bulinrutss/injet-racing/implementacoes-futuras/README.md

# Implementações futuras — INJET RACING

Ideias **fora do escopo da Fase 1** (placa atual). Não implementar na prodv6 até o item ser puxado daqui.

| ID | Item | Prioridade | Status |
|----|---|---|---|
| FUT-01 | [3-step / rev-limit por corte de bobina](./FUT-01-3step-corte-bobina.md) | Alta (pista) | Ideia salva |
| FUT-02 | [Driver relé IRLZ44N / módulo opto (bobina >150 mA)](./FUT-02-rele-driver-irlz44n.md) | Baixa (só se relé pesado no chicote) | Ideia salva |
| FUT-03 | [Drag Star 650 · TBI comum + RPM (bobina vs pick-up)](./FUT-03-dragstar-650-tbi-rpm.md) | Média (piloto moto) | Ideia salva |
| FUT-04 | [Roda fônica · dentes · vs bobina](./FUT-04-roda-fonica-rpm.md) | Fase 2 | Referência |
| FUT-05 | [Condicionador VR · pick-up / distribuidor 2 fios](./FUT-05-condicionador-vr-pickup.md) | Fase 2 | Ideia salva |

**Regra:** cut de combustível **não** serve para 3-step / limiter sob carga — só faísca (bobina).
