bulinrutss/injet-racing/modulo/anotações.txt

espaço entre trilhas
colocar leds

me explique pq isso, pq funciona, então vamos dizer q se eu estendesse essa trilha 30cm e colocasse la os 2 cap, as dias pontas ainda são iguais?
