bulinrutss/injet-racing/assets/ecu-pcb-1layer-drc.md

# DRC

- Cruzamentos cobre: **0**
- Trilhas CNC: 86
- Fios topo (AWG28 pad–pad): **43**
- Placa: 240.0×160.0 mm
- GND: **pour** (sem fio de terra)

Sem tarja nas imagens.

## Fios topo

- `INJ2`
- `GI2`
- `INJ3`
- `INJ4`
- `RL1`
- `GR1`
- `RL2`
- `GR2`
- `RL3`
- `GR3`
- `IAT`
- `CLT`
- `MAP`
- `TPS`
- `RPMi`
- `RPMo`
- `CANH`
- `CANL`
- `IP`
- `VM`
- `VM`
- `UN`
- `RI`
- `VREF`
- `SWDIO`
- `SWCLK`
- `+12V`
- `+12V`
- `+12V`
- `+12V`
- `+12V`
- `+12V`
- `+5V`
- `+5V`
- `+5V`
- `+5V`
- `+3V3`
- `+3V3`
- `+3V3`
- `+3V3`
- `+3V3`
- `+3V3`
- `+3V3`
