bulinrutss/injet-racing/assets/ecu-pcb-prodv2-drc.md

# DRC — INJET RACING ECU prodv2 (1 camada)

- Placa: **240.0×160.0 mm** (maior que prod 200×100 — necessário para 0 curto)
- Cruzamentos cobre (nets diferentes): **0**
- Trilhas CNC (B.Cu): **86**
- Fios/jumpers TOPO: **43**
- Pads: **257**

## Estratégia

1. **GND = copper pour** — não roteado como trilha (evita ~30% dos conflitos)
2. **Canais horizontais** — 1 net por faixa Y para sinais
3. **`would_cross()`** — rejeita qualquer cruzamento; vira fio topo
4. **Potência por último** — barramentos +12V/+5V/+3V3 nas bordas

## Fios TOPO (soldar após CNC)

- `INJ2` (90.0,40.0) → (16.0,8.0)
- `GINJ2` (100.0,97.0) → (87.5,60.0)
- `INJ3` (108.0,40.0) → (20.0,8.0)
- `INJ4` (126.0,40.0) → (24.0,8.0)
- `RL1` (17.3,112.0) → (32.0,8.0)
- `GRL1` (100.0,86.8) → (16.0,96.0)
- `RL2` (31.3,112.0) → (28.0,8.0)
- `GRL2` (100.0,84.3) → (30.0,96.0)
- `RL3` (45.3,112.0) → (36.0,8.0)
- `GRL3` (100.0,81.7) → (44.0,96.0)
- `IAT` (40.0,14.0) → (176.0,128.0)
- `CLT` (44.0,14.0) → (176.0,116.0)
- `MAP` (48.0,14.0) → (176.0,104.0)
- `TPS` (52.0,14.0) → (184.0,92.0)
- `RPM_IN` (56.0,14.0) → (42.0,86.0)
- `RPM_OUT` (67.6,80.0) → (100.0,107.1)
- `CANH` (128.0,90.0) → (40.0,8.0)
- `CANL` (134.0,90.0) → (44.0,8.0)
- `IP` (200.0,60.0) → (152.0,112.2)
- `VM` (172.0,42.0) → (200.0,8.0)
- `VM` (202.0,46.5) → (200.0,8.0)
- `UN` (192.0,66.0) → (152.0,107.1)
- `RI_PULSE` (152.0,104.6) → (200.0,66.0)
- `VREF` (88.0,138.0) → (78.0,150.0)
- `SWDIO` (118.5,70.0) → (152.0,97.0)
- `SWCLK` (121.1,70.0) → (152.0,94.4)
- `+12V_PROT` (66.0,32.0) → (148.0,32.0)
- `+12V_PROT` (148.0,32.0) → (70.0,157.0)
- `+12V_PROT` (20.0,104.0) → (70.0,157.0)
- `+12V_PROT` (34.0,104.0) → (70.0,157.0)
- `+12V_PROT` (48.0,104.0) → (70.0,157.0)
- `+12V_PROT` (200.0,14.0) → (162.0,28.0)
- `+5V` (116.0,90.0) → (116.0,142.0)
- `+5V` (164.0,50.0) → (150.0,142.0)
- `+5V` (179.6,42.0) → (150.0,142.0)
- `+5V` (32.0,14.0) → (56.0,142.0)
- `+3V3` (168.0,128.0) → (168.0,136.0)
- `+3V3` (168.0,116.0) → (168.0,136.0)
- `+3V3` (168.0,104.0) → (168.0,136.0)
- `+3V3` (70.0,90.0) → (70.0,148.0)
- `+3V3` (116.0,70.0) → (116.0,148.0)
- `+3V3` (100.0,130.0) → (100.0,148.0)
- `+3V3` (36.0,14.0) → (72.0,148.0)

## vs injet-racing-prod

| | prod | prodv2 |
|---|---|---|
| Tamanho | 200×100 mm | 240×160 mm |
| Cruzamentos | ~896 | **0** |
| Jumpers topo | 0 | ~43 |
| GND | trilhas | **pour** |
