bulinrutss/injet-racing/assets/ecu-pcb-prodv3-drc.md

# DRC — INJET RACING ECU prodv3 (2 camadas FR4)

- Placa: **240.0×160.0 mm**
- **B.Cu:** 60 trilhas (roteamento principal prodv2)
- **F.Cu:** 25 trilhas (ex-jumpers prodv2 → cobre topo)
- **Fios/jumpers:** **0**
- **Vias F↔B:** **11**
- Cruzamentos B.Cu: **0**
- Cruzamentos F.Cu: **0**
- Sobreposição B.Cu: **0**
- Sobreposição F.Cu: **0**

## Stackup

| Camada | Função |
|---|---|
| F.Cu | Componentes THT + trilhas de ligação (face componentes) |
| FR4 | Core 1.6 mm |
| B.Cu | Trilhas principais + GND pour |

## vs prodv2

| | prodv2 | prodv3 |
|---|---|---|
| Camadas cobre | 1 (B.Cu) | **2 (F.Cu + B.Cu)** |
| Fios topo | 43 | **0** |
