bulinrutss/injet-racing/projetos piloto/README.md

# Projetos piloto — INJET RACING

Protótipos e produtos **fora** da placa ECU Fase 1 (prodv6). Cada subpasta = um piloto com documentação própria.

| Piloto | Status | Pasta |
|---|---|---|
| INJET 3 Step (limitador giros tipo ODG) | Documentado | [injet 3 step/](./injet%203%20step/) |

**Regra:** não implementar na prodv6 até puxar item de `implementacoes-futuras/` ou desta pasta para escopo ativo.
