bulinrutss/injet-racing/TBI's.xlsx - MOTO x TBI.pdf

## Lista de TBI's Compatíveis

A lista é seguir é uma referência / sugestão de TBI's (Corpo de Injeção) que são compatíveis com determinados modelos de moto. A instalação da TBI na moto é uma adaptação e está sucetível à ajustes para um perfeito encaixe no motor.

MOTO | TBI
Honda CG 125/150 | Honda CG 150
Honda CBX 250 Twister | Honda CB 250 Twister ou CB 300
Honda XR 250 Tornado | Honda CB 250 Twister ou CB 300
Honda NX-4 Falcon 400 | Honda NX-4 Falcon 400 ou CB 300
Honda CRF 230 | Honda CB 250 Twister ou CB 300
Honda NX 350 Sahara | Honda CB 300
Honda CB 400/450 | Honda CB 500X
Honda CBX 750 | Honda Hornet 600
Honda CBR 450 SR | 2 TBI de Fazer 250
Honda CB 500 | Honda CB 500X
Honda CBR 600 | Honda Hornet 600
Honda Shadow 600 (1 Carburador) | Honda Shadow 750 (Coletor de Admissão e Corpo de Injeção)
Honda Shadow 600 (2 Carburadores) | Yamaha Fazer 250 (2 TBI's) - Cabo de Acelerador Mirage 250
Honda Shadow 750 | Honda Shadow 750 (Coletor de Admissão e Corpo de Injeção)
Yamaha Crypton 115 | Honda Pop 110 ou Honda BIZ 125
Yamaha YBR 125 | Yamaha Fazer 150
Yamaha DT 200 | Yamaha Fazer 250 ou Honda Twister 250
Yamaha Virago 535 | Yamaha Fazer 250 (2 TBI's) - Cabo de Acelerador Mirage 250
Yamaha Virago 750 | Honda CB 300 (2 TBI's)

Yamaha Drag Star 650 | Yamaha Fazer 250 (2 TBI's) - Cabo de Acelerador Mirage 250
Yamaha XT 600 / Ténéré 600 | Yamaha MT 03
Yamaha Super Ténéré 750 | BMW F800
Yamaha TDM 850 | BMW F800
Yamaha VMax 1200 | Sugerimos não usar TBI.
Suzuki Intruder 250 | Yamaha Fazer 250
Suzuki GS 500 | Yamaha Fazer 250 (2 TBI's) - Cabo de Acelerador Mirage 250
Suzuki GSX 750 | Suzuki Bandit 650 ou 1.250
Suzuki GSXR 1100w | Suzuki Bandit 650 ou 1.250
Suzuki DR 650 | BMW F650 GS
Suzuki DR 800 | BMW F800
Suzuki LS 650 Savage | BMW F650 GS
Suzuki VZ 800 Marauder | Honda CB 300 (2 TBI's)
Suzuki VS 800 Intruder | Honda CB 300 (2 TBI's)
Suzuki VS 1400 Intruder | Honda CB 300 (2 TBI's)
Kawasaki Ninja Zx11 | Suzuki Bandit 1.250, Z 800
Kawasaki Vulcan 750 | Kasinski Mirage 650 (2 TBI's)
Dafra Horizon 150 | Honda CG 150
Kawasaki Ninja Zx9R | KAWASAKI Z800
Suzuki Bandit 600 | Bandit 650
Sundown 125 | Burgman 125

Observações

Na adaptação pelo carburador, não usa TPS/Reading Box
