bulinrutss/injet-racing/assets/bico-0280156086.png

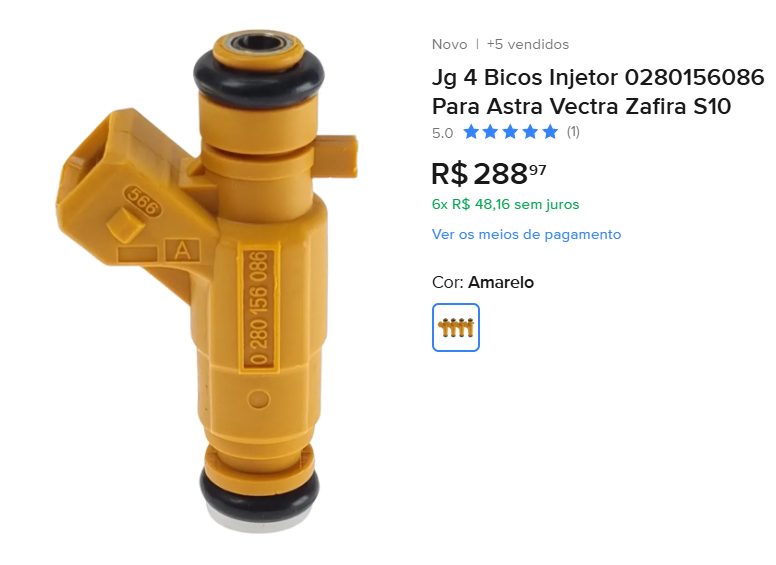
assets/bico-0280156086.png
