bulinrutss/injet-racing/assets/corpo-completo-tbi-3d-v6.png

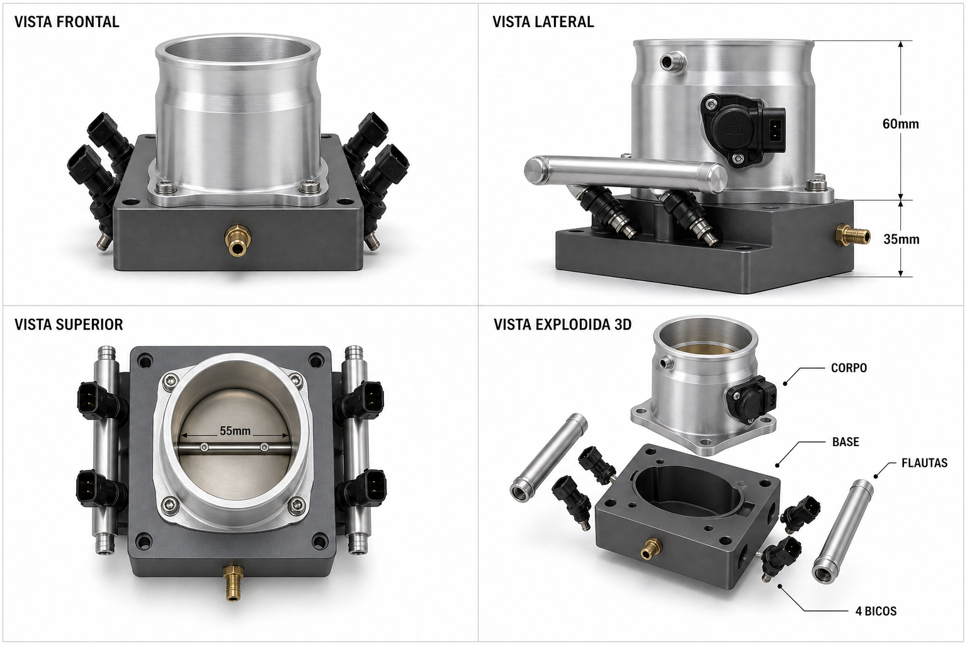
assets/corpo-completo-tbi-3d-v6.png
