bulinrutss/injet-racing/assets/ecu-fenolite-100x200-layout.png

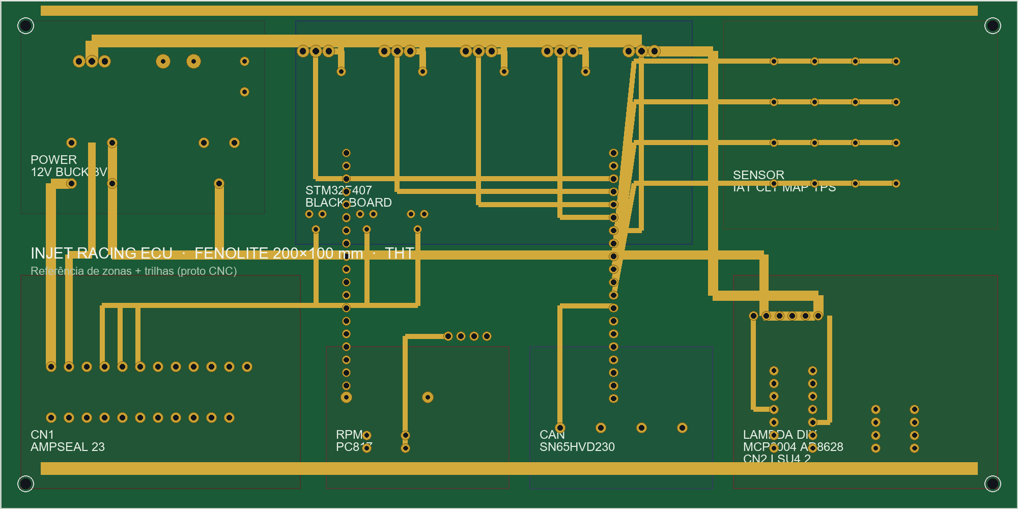
assets/ecu-fenolite-100x200-layout.png
