bulinrutss/injet-racing/assets/ecu-fenolite-100x200-traces-cnc-invert.png

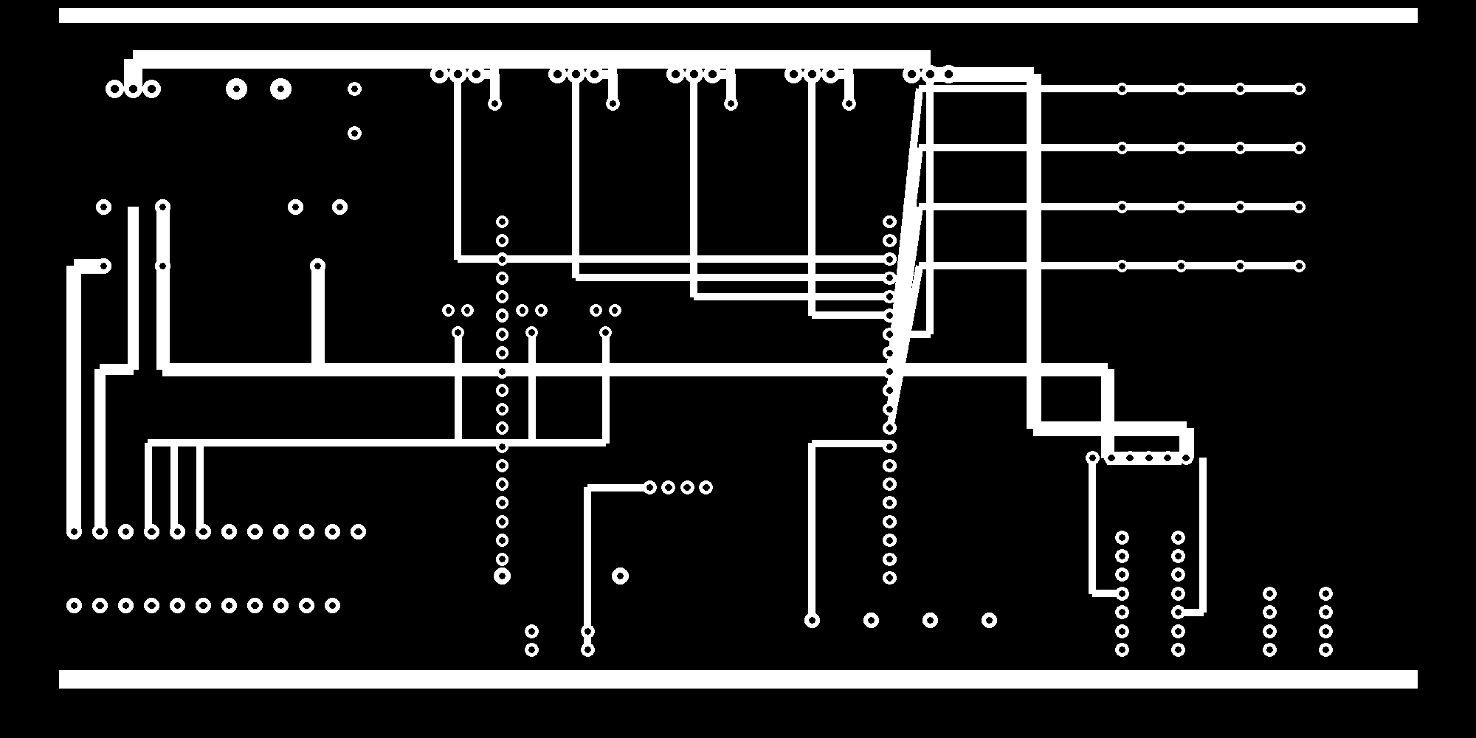
assets/ecu-fenolite-100x200-traces-cnc-invert.png
