bulinrutss/injet-racing/assets/ecu-fenolite-100x200-traces-cnc.png

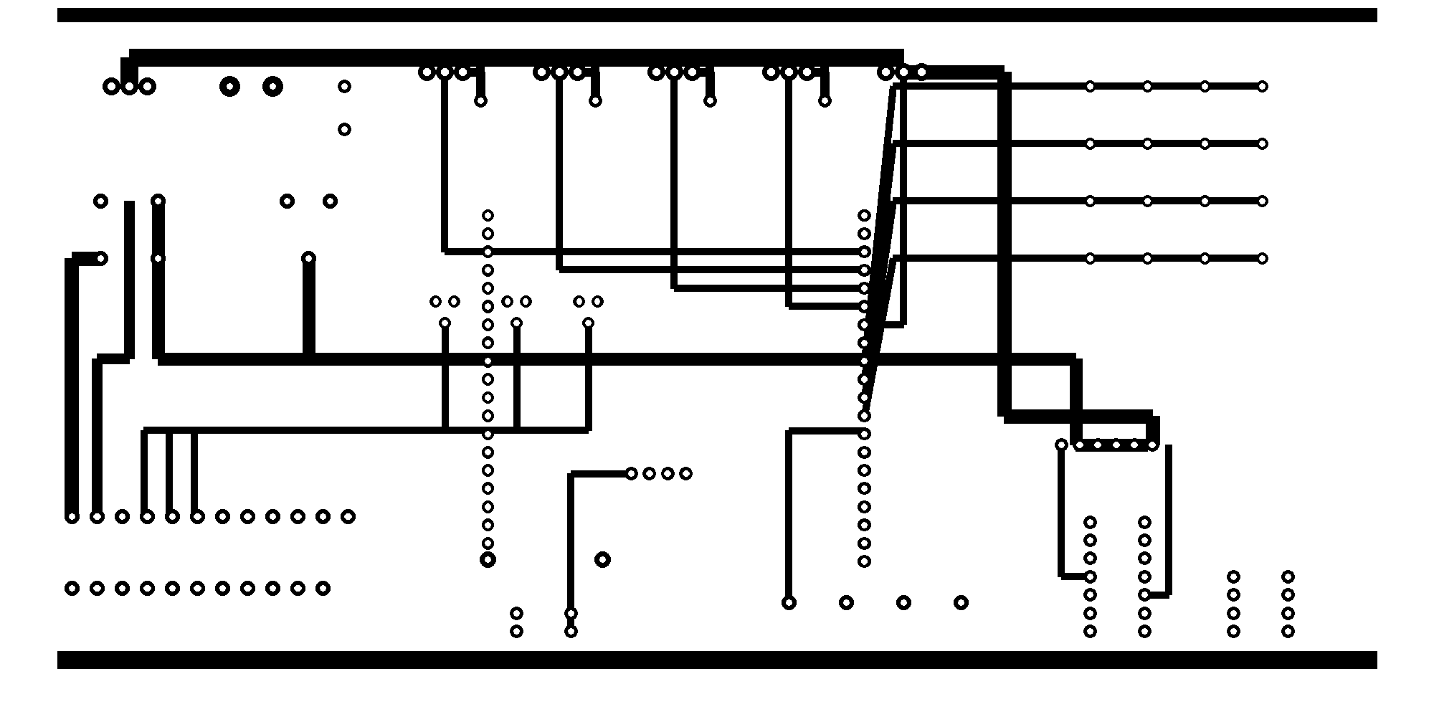
assets/ecu-fenolite-100x200-traces-cnc.png
