bulinrutss/injet-racing/assets/ecu-pcb-1layer-pads-map.png

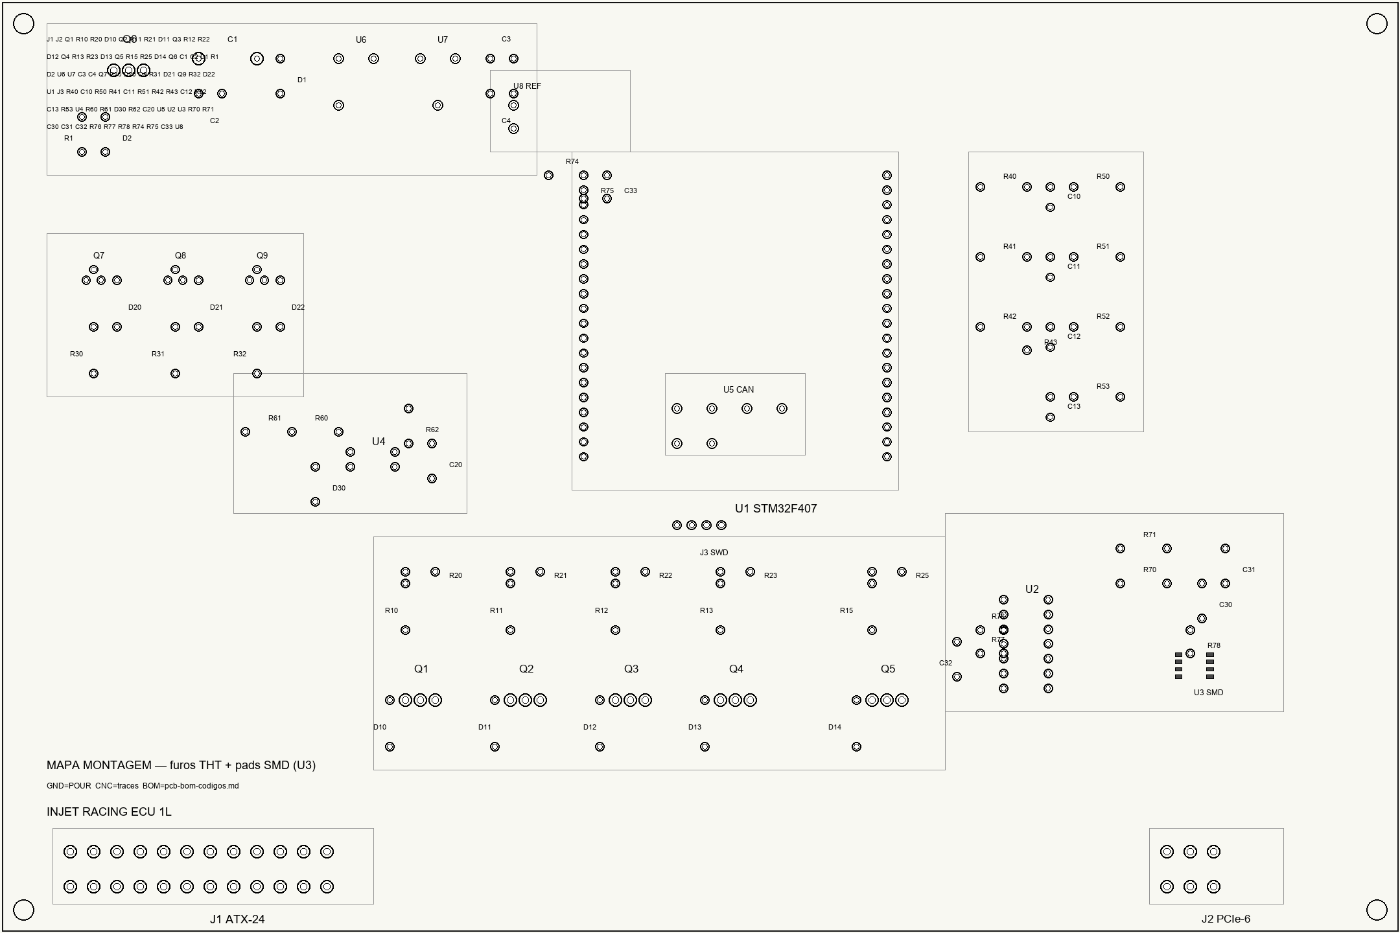
assets/ecu-pcb-1layer-pads-map.png
