bulinrutss/injet-racing/assets/ecu-pcb-1layer-traces-cnc-invert.png

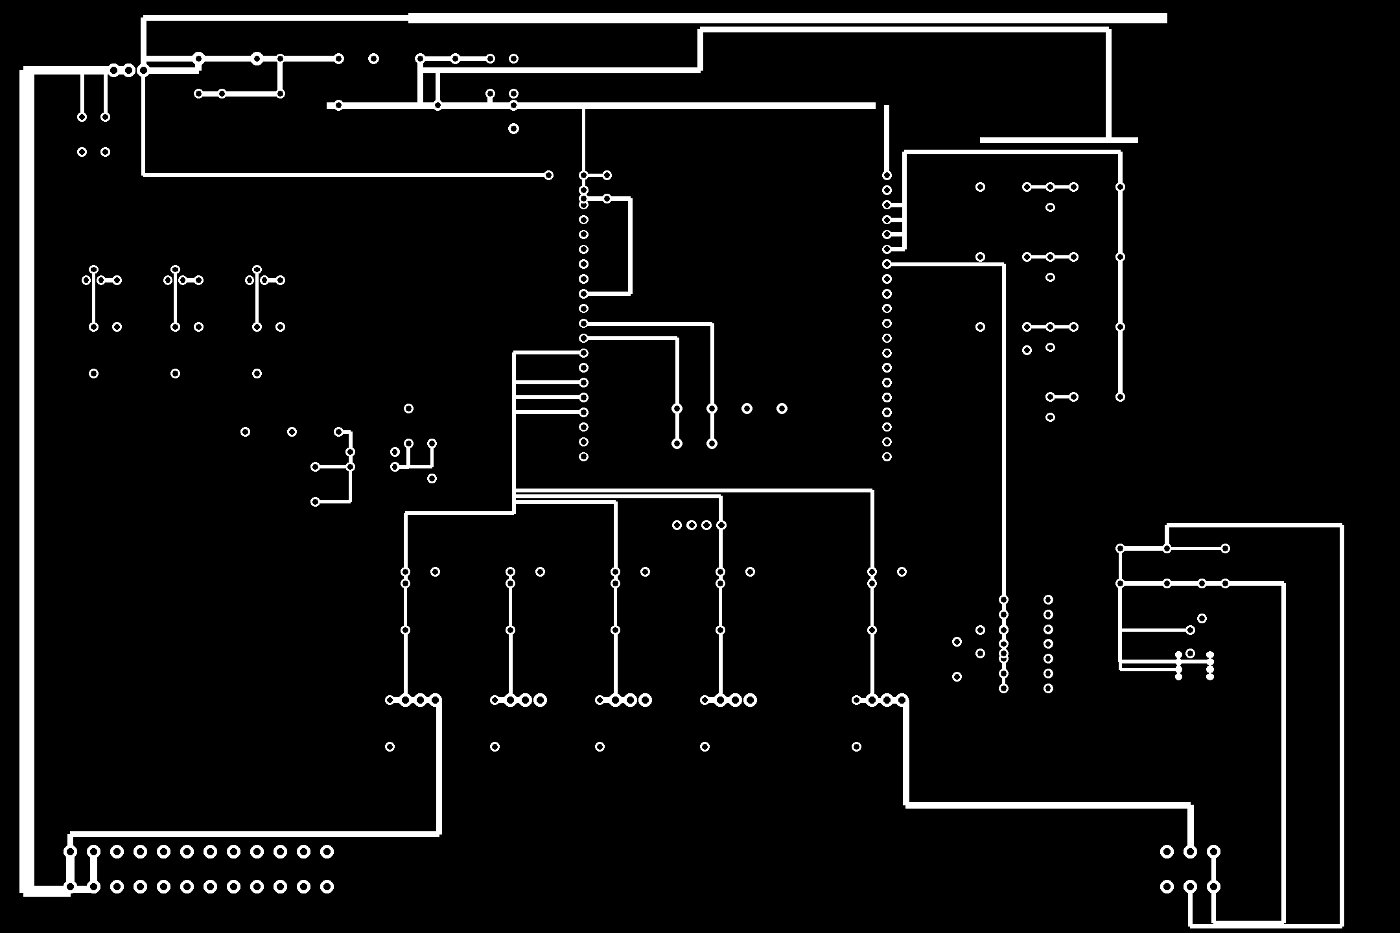
assets/ecu-pcb-1layer-traces-cnc-invert.png
