bulinrutss/injet-racing/assets/flange-55mm-3d-v5.png

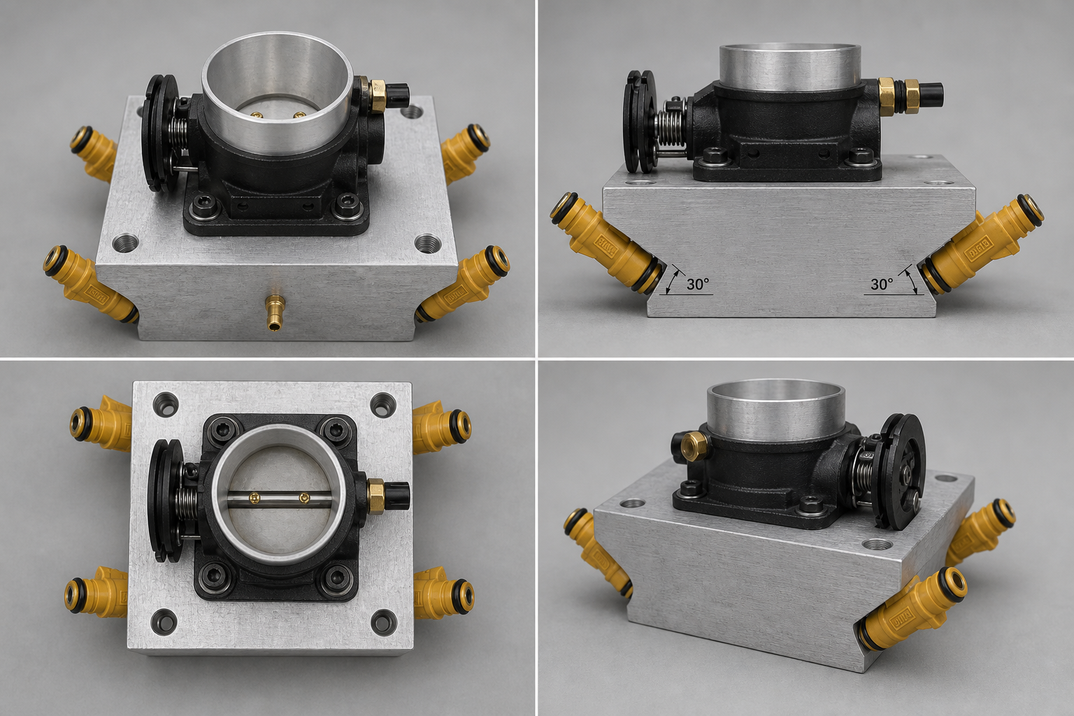
assets/flange-55mm-3d-v5.png
