bulinrutss/injet-racing/assets/flange-55mm-cotas-v5.png

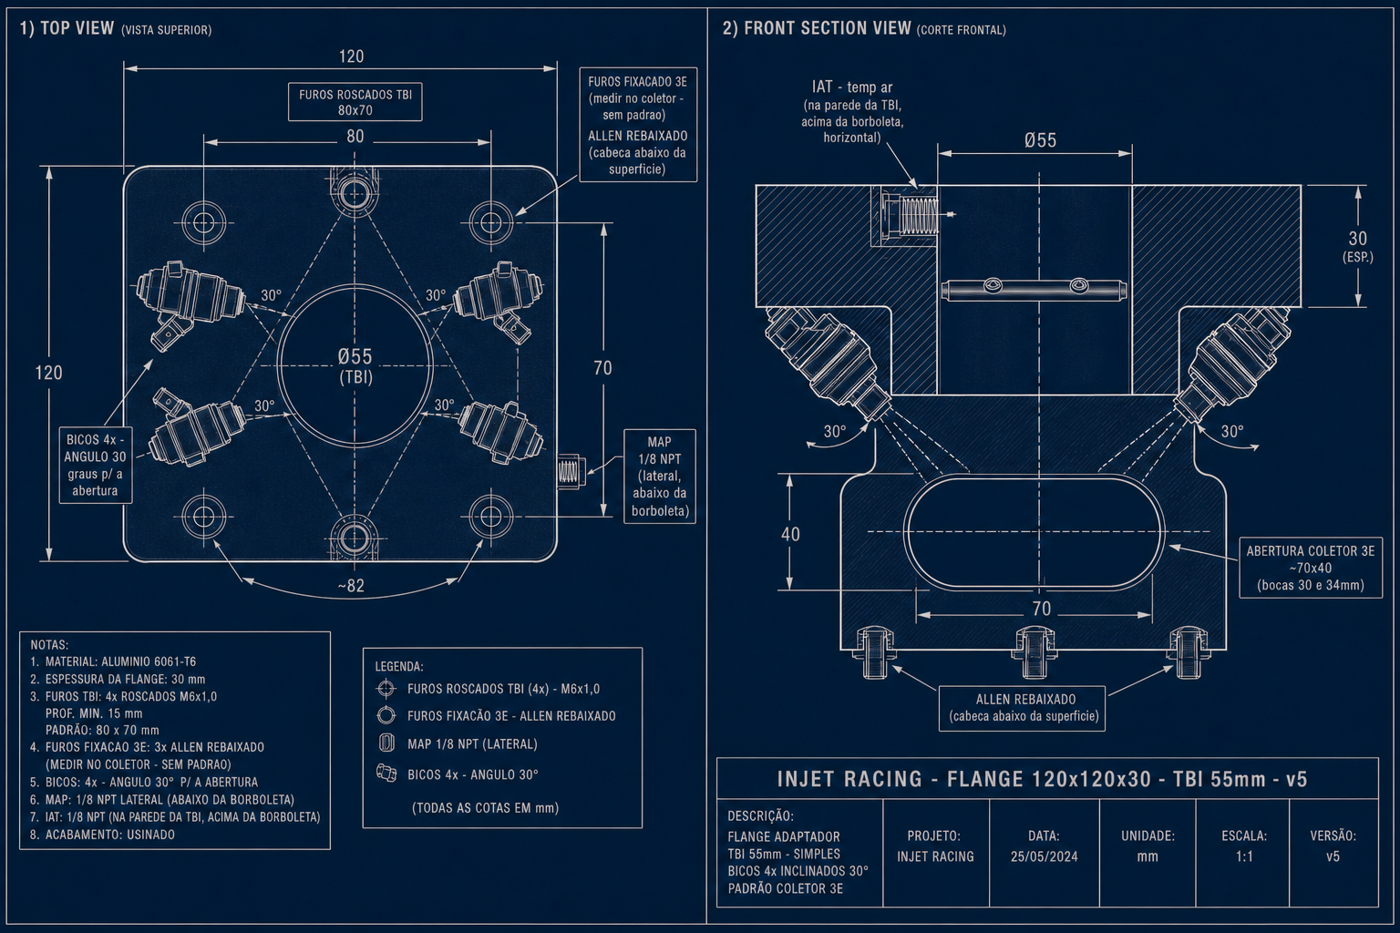
assets/flange-55mm-cotas-v5.png
