bulinrutss/injet-racing/assets/flange-55mm-passos-v5.png

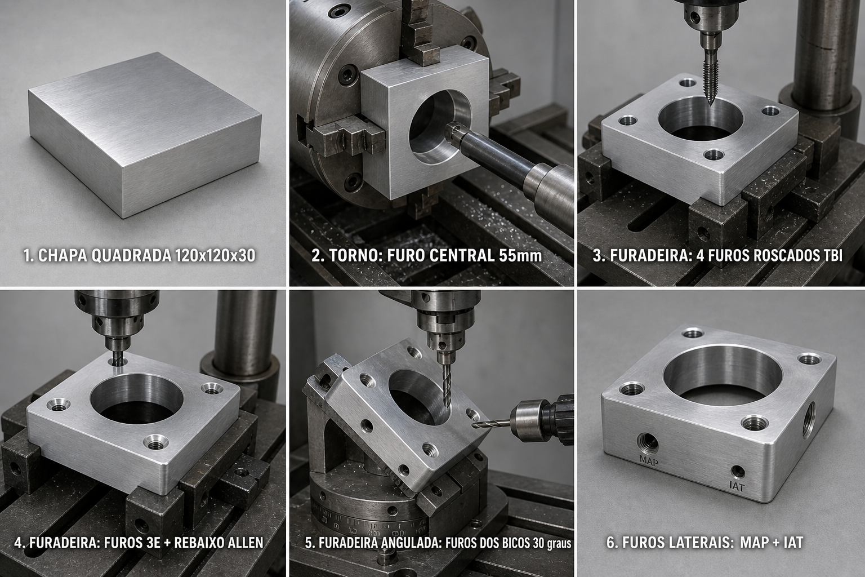
assets/flange-55mm-passos-v5.png
