bulinrutss/injet-racing/assets/flange-tbi-3d-4angulos.png

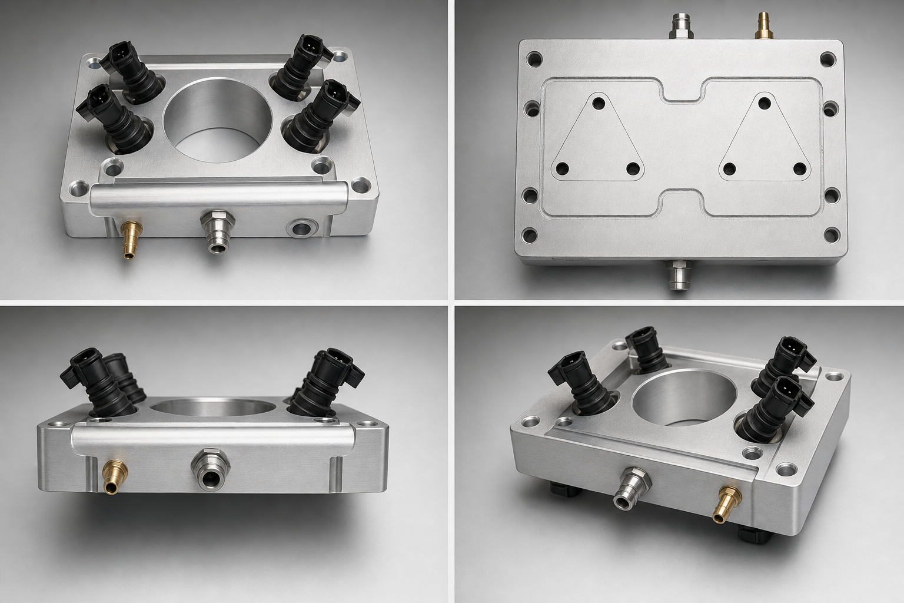
assets/flange-tbi-3d-4angulos.png
