bulinrutss/injet-racing/assets/flange-tbi-3d-v2.png

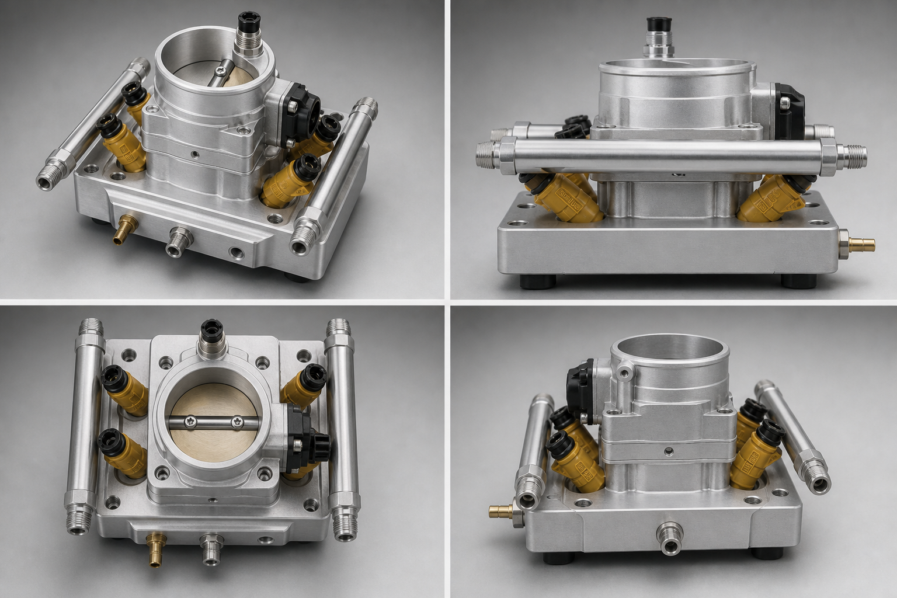
assets/flange-tbi-3d-v2.png
