bulinrutss/injet-racing/assets/flange-tbi-3d-v3.png

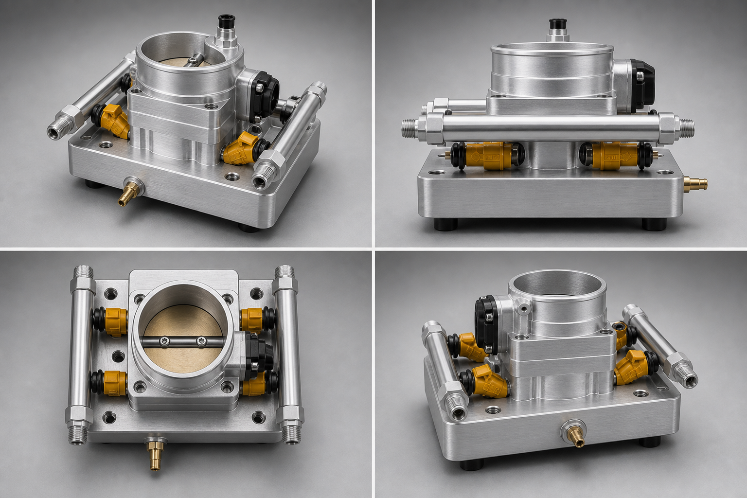
assets/flange-tbi-3d-v3.png
