bulinrutss/injet-racing/assets/flange-tbi-cotas-v2.png

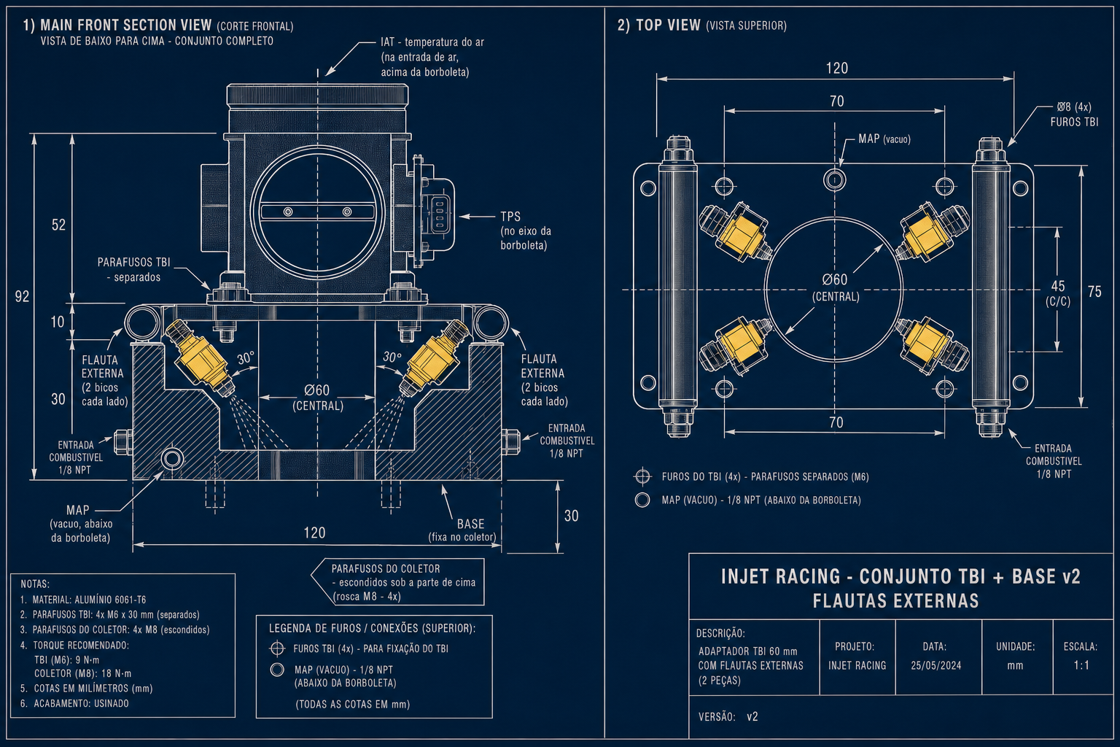
assets/flange-tbi-cotas-v2.png
