bulinrutss/injet-racing/assets/flange-tbi-cotas-v3.png

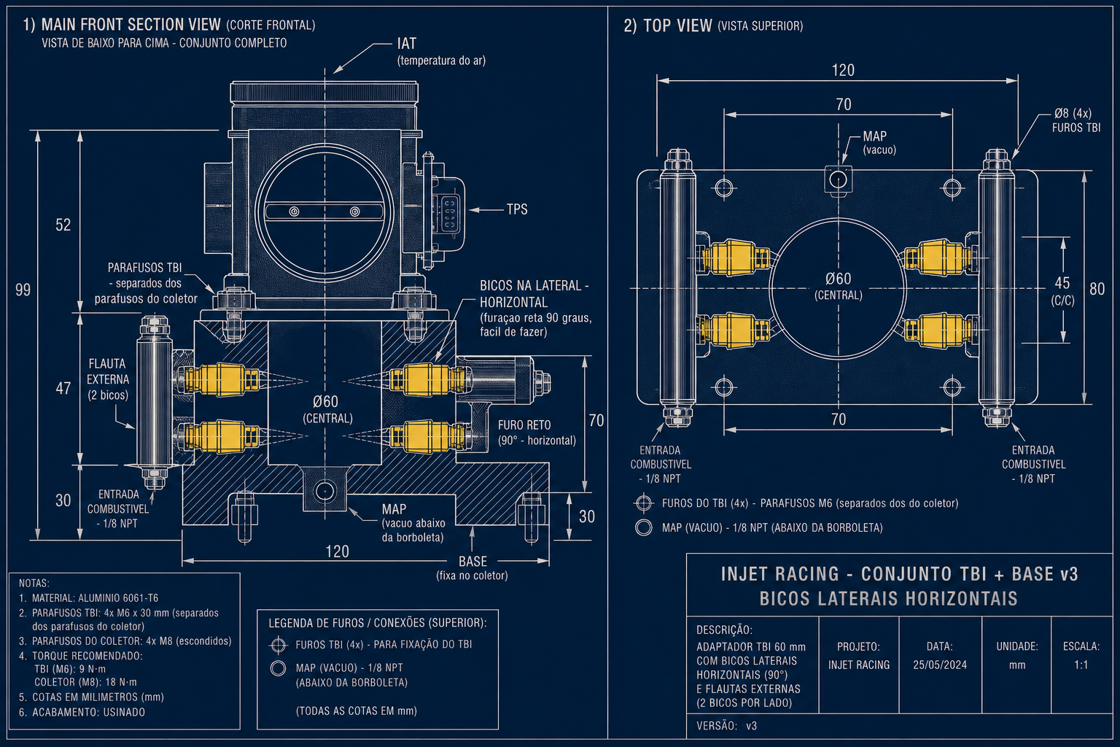
assets/flange-tbi-cotas-v3.png
