bulinrutss/injet-racing/assets/flange-tbi-cotas.png

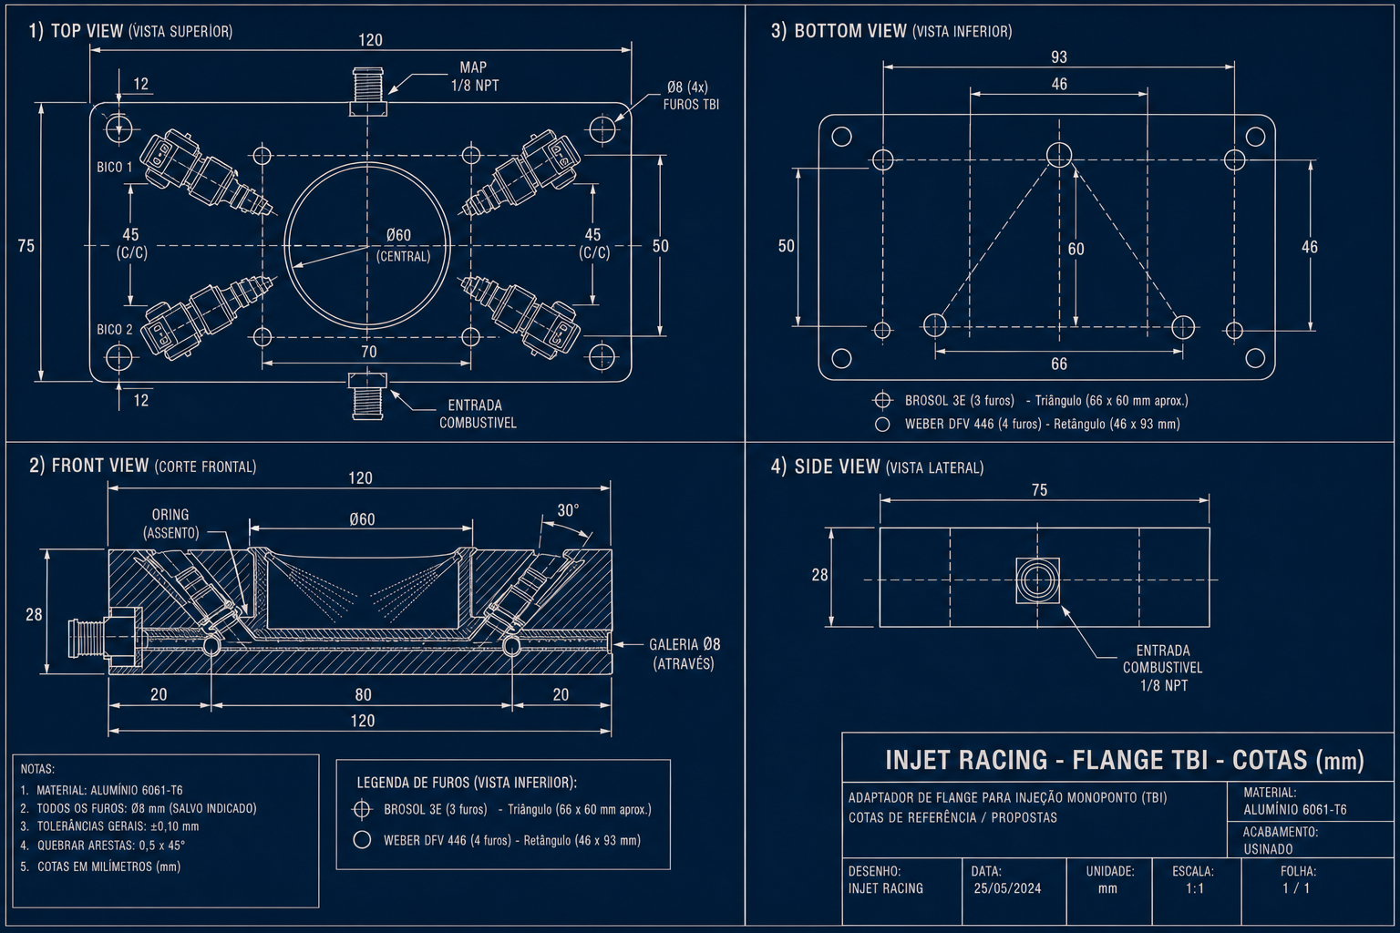
assets/flange-tbi-cotas.png
