bulinrutss/injet-racing/assets/flange-tbi-explodida-v2.png

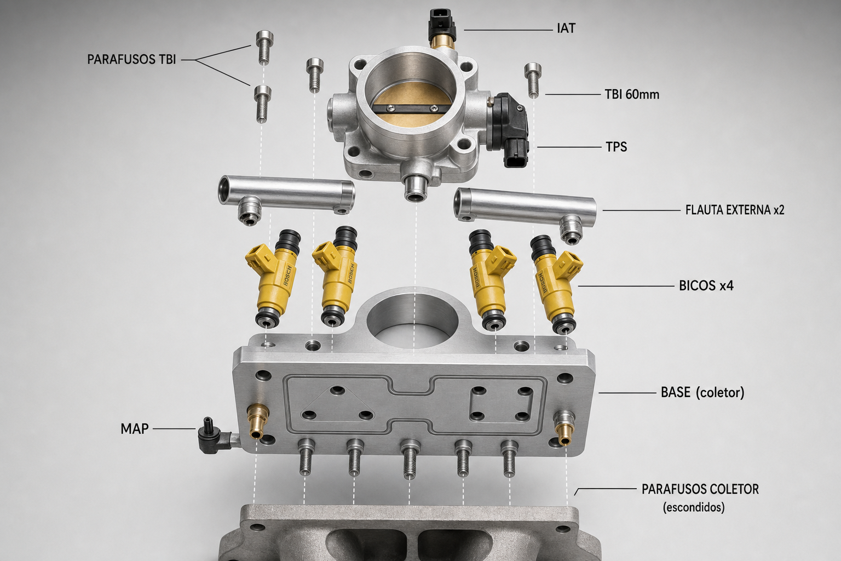
assets/flange-tbi-explodida-v2.png
