bulinrutss/injet-racing/assets/flange-tbi-explodida-v3.png

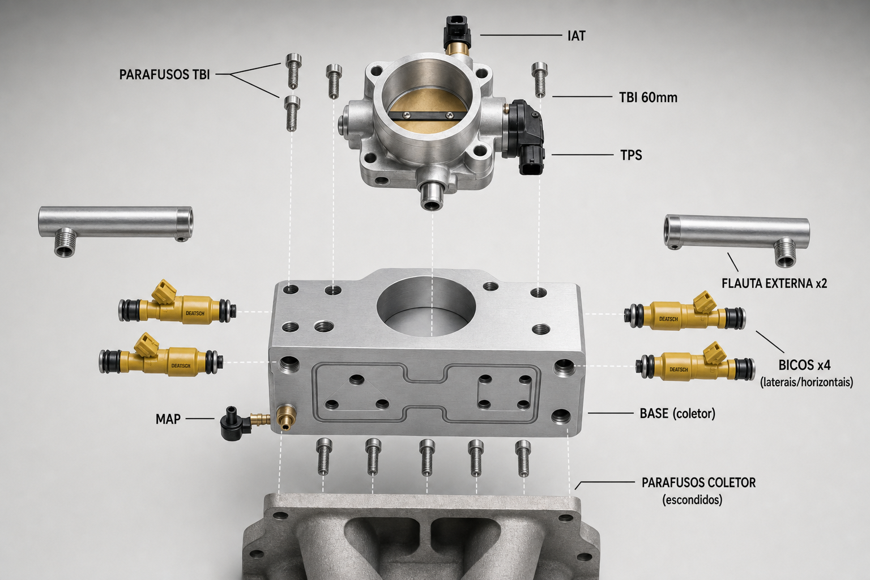
assets/flange-tbi-explodida-v3.png
