bulinrutss/injet-racing/assets/flange-tbi-projeto.png

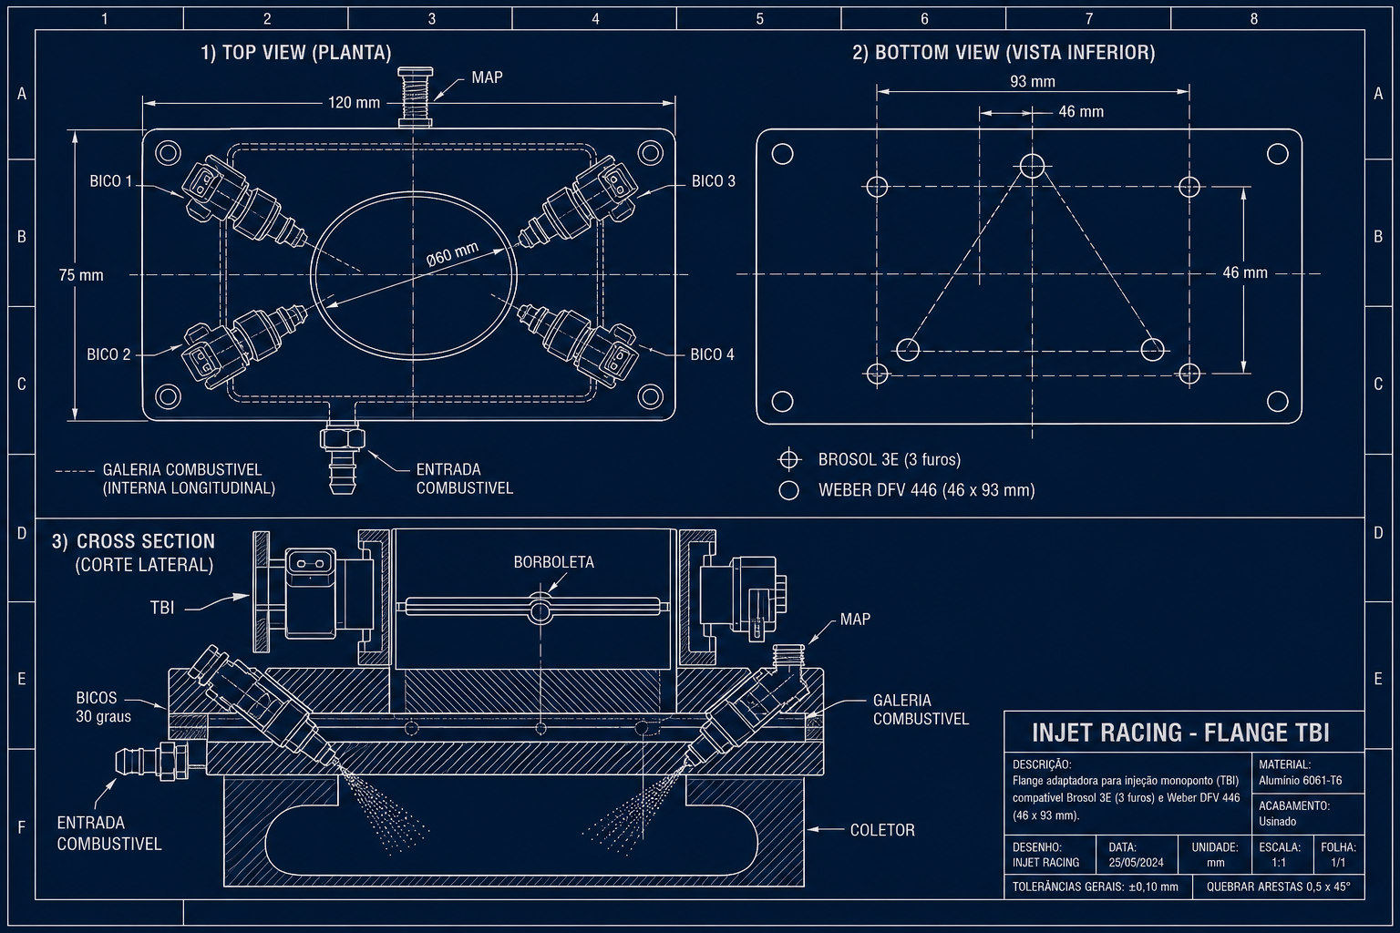
assets/flange-tbi-projeto.png
