bulinrutss/injet-racing/assets/flange-torno-3d-v4.png

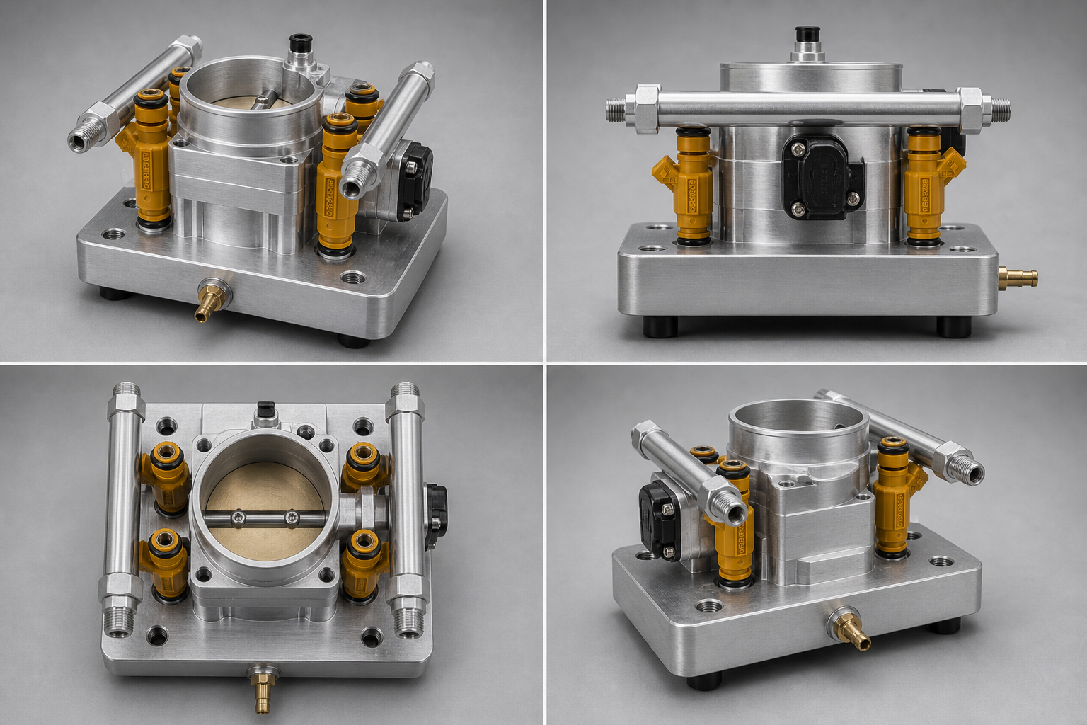
assets/flange-torno-3d-v4.png
