bulinrutss/injet-racing/assets/flange-torno-passos-v4.png

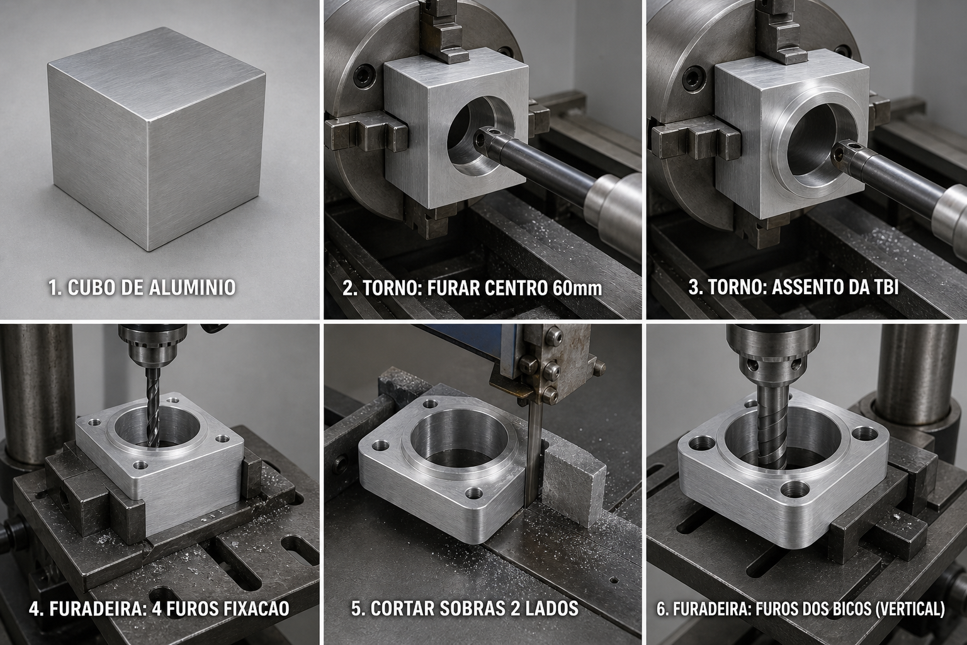
assets/flange-torno-passos-v4.png
