bulinrutss/injet-racing/assets/tbi-55mm-furacao.png

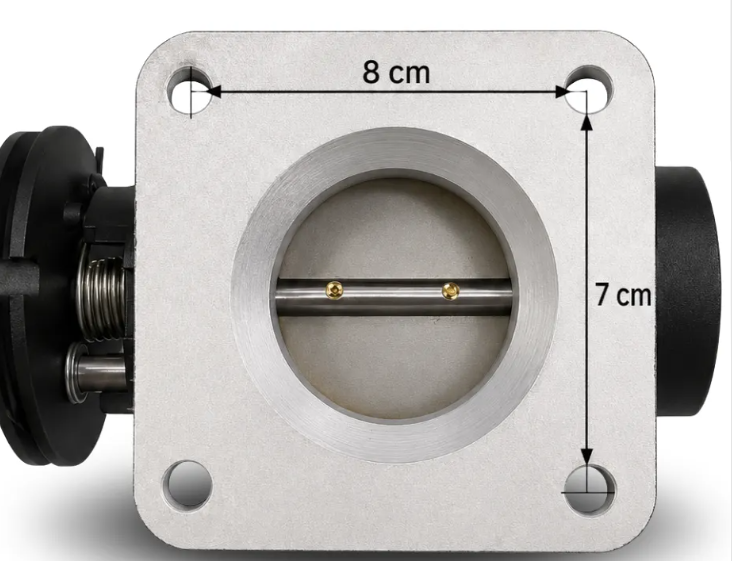
assets/tbi-55mm-furacao.png
