bulinrutss/injet-racing/assets/tbi-55mm-vista.png

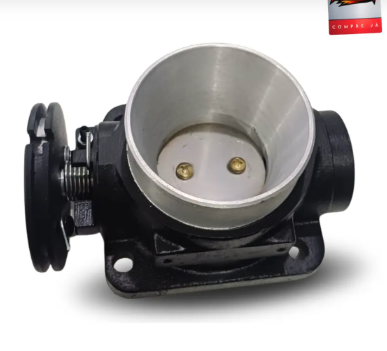
assets/tbi-55mm-vista.png
