bulinrutss/injet-racing/projetos piloto/injet 3 step/README.md

# INJET 3 Step — projeto piloto

Limitador de giros tipo ODG 3-step (burn-out / pre-stage / corte final + shift light), corte na **bobina**, produto **standalone** fora da prodv6 Fase 1.

| Arquivo | Conteúdo |
|---|---|
| [01-projeto-detalhado.md](./01-projeto-detalhado.md) | Objetivo, tecnologia ODG, instalação A/B/C, BOM, riscos, próximos passos |
| [02-custos.md](./02-custos.md) | Preços Ali / BR / ML, solda, fabricação, totais |
| [03-tempo-fabricacao.md](./03-tempo-fabricacao.md) | Horas CNC, solda, 3D, chicote, firmware, cronograma |

**Relacionado:** `implementacoes-futuras/FUT-01-3step-corte-bobina.md`
