bulinrutss/injet-racing/assets/ecu-pcb-prodv2-assembly.png

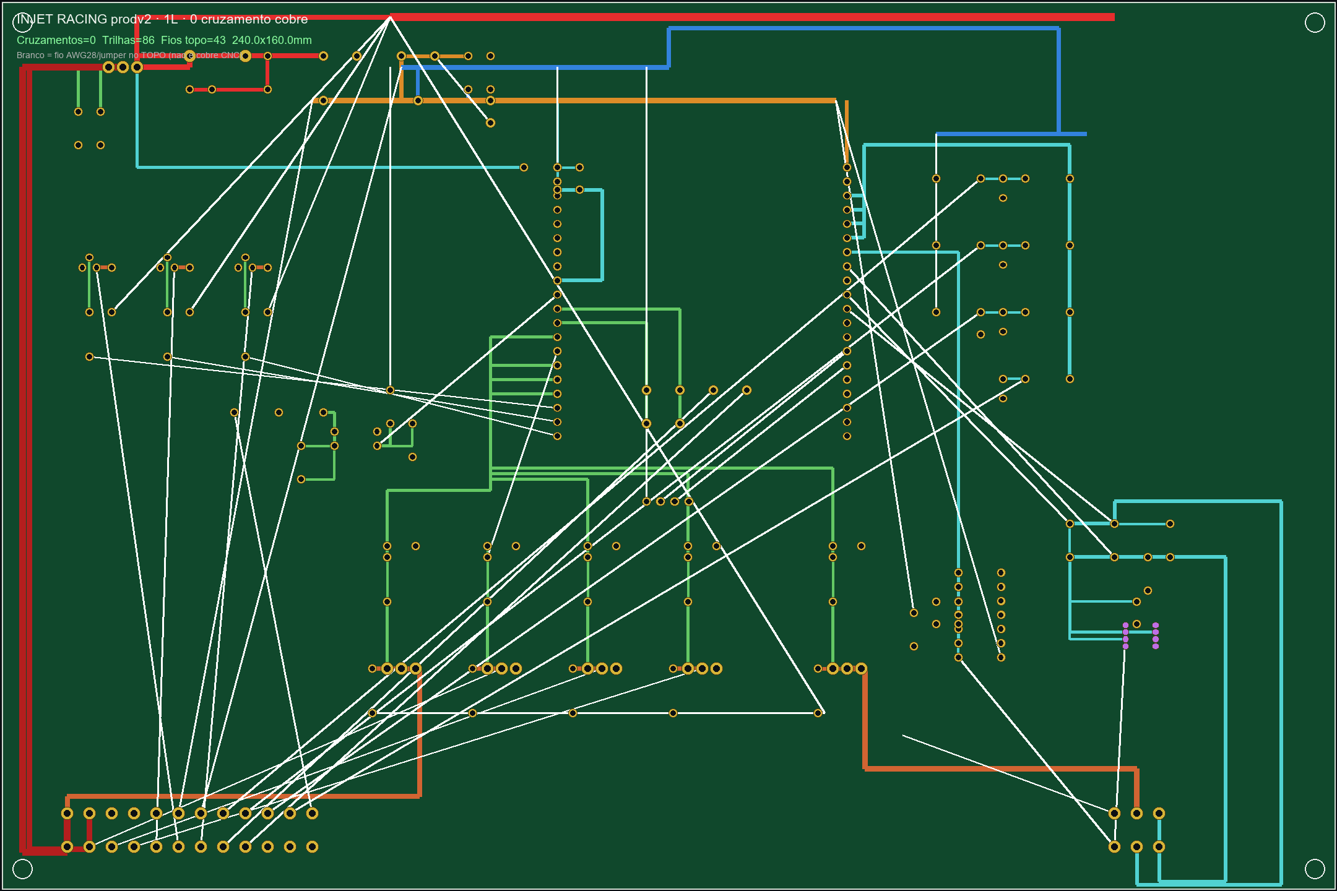
assets/ecu-pcb-prodv2-assembly.png
