bulinrutss/injet-racing/assets/ecu-pcb-prodv3-assembly.png

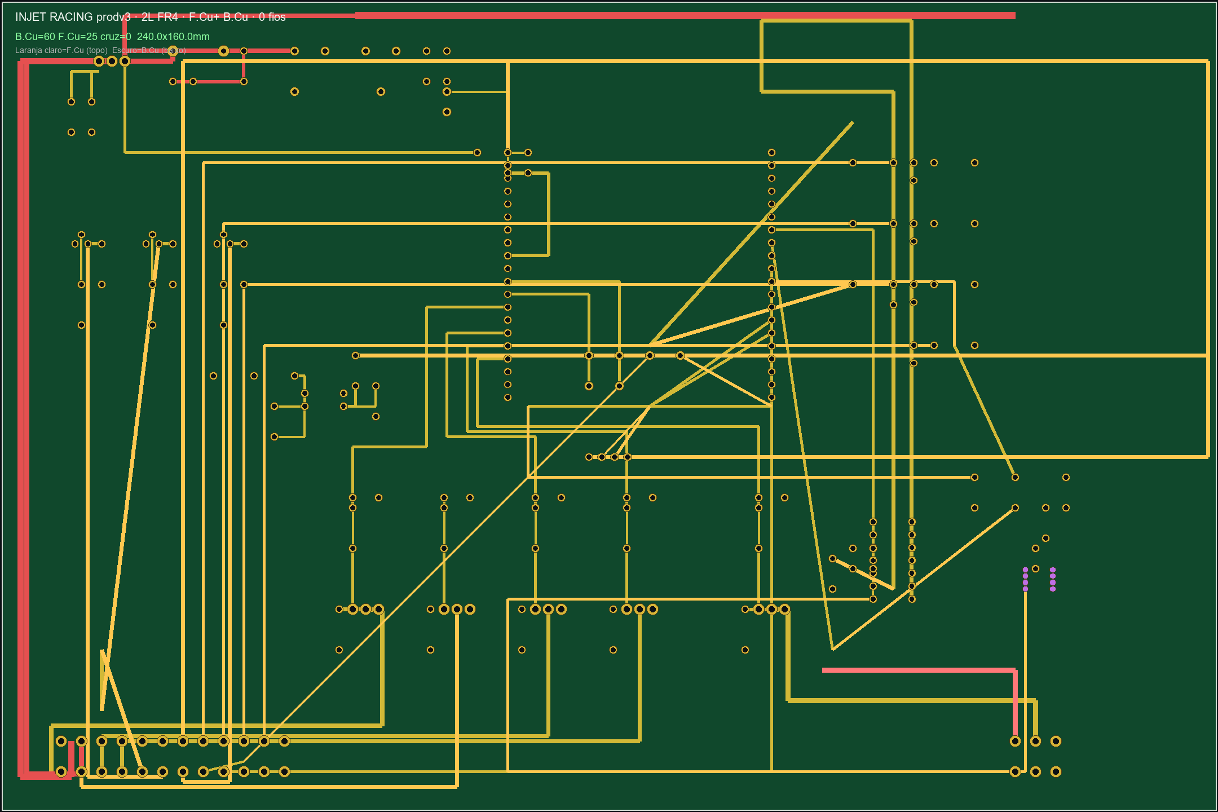
assets/ecu-pcb-prodv3-assembly.png
