bulinrutss/injet-racing/kicad/prodv6/injet-racing-prodv6.kicad_pcb

## KiCad design kicad/prodv6/injet-racing-prodv6.kicad_pcb (2026-11-11)

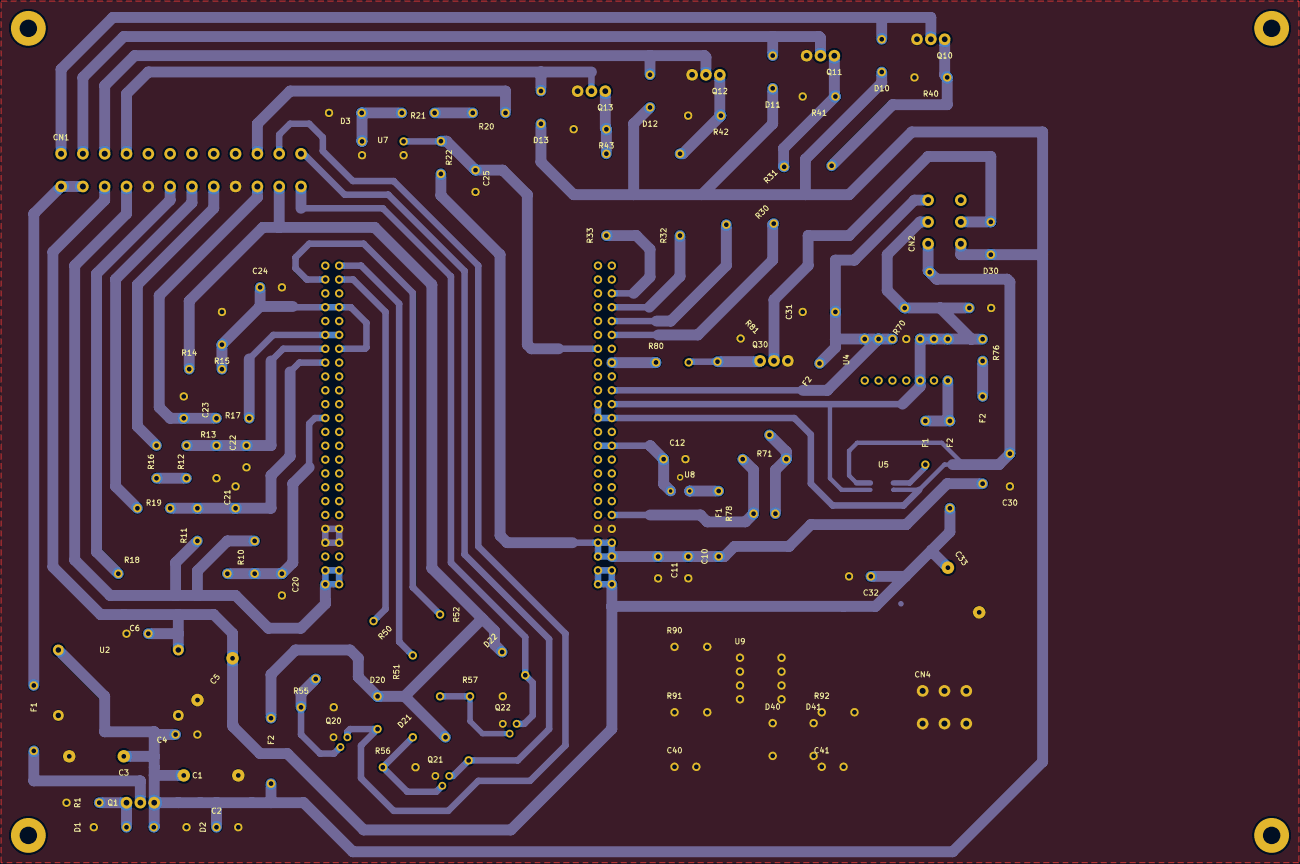
[picture p33: board injet-racing-prodv6.kicad_pcb from above]

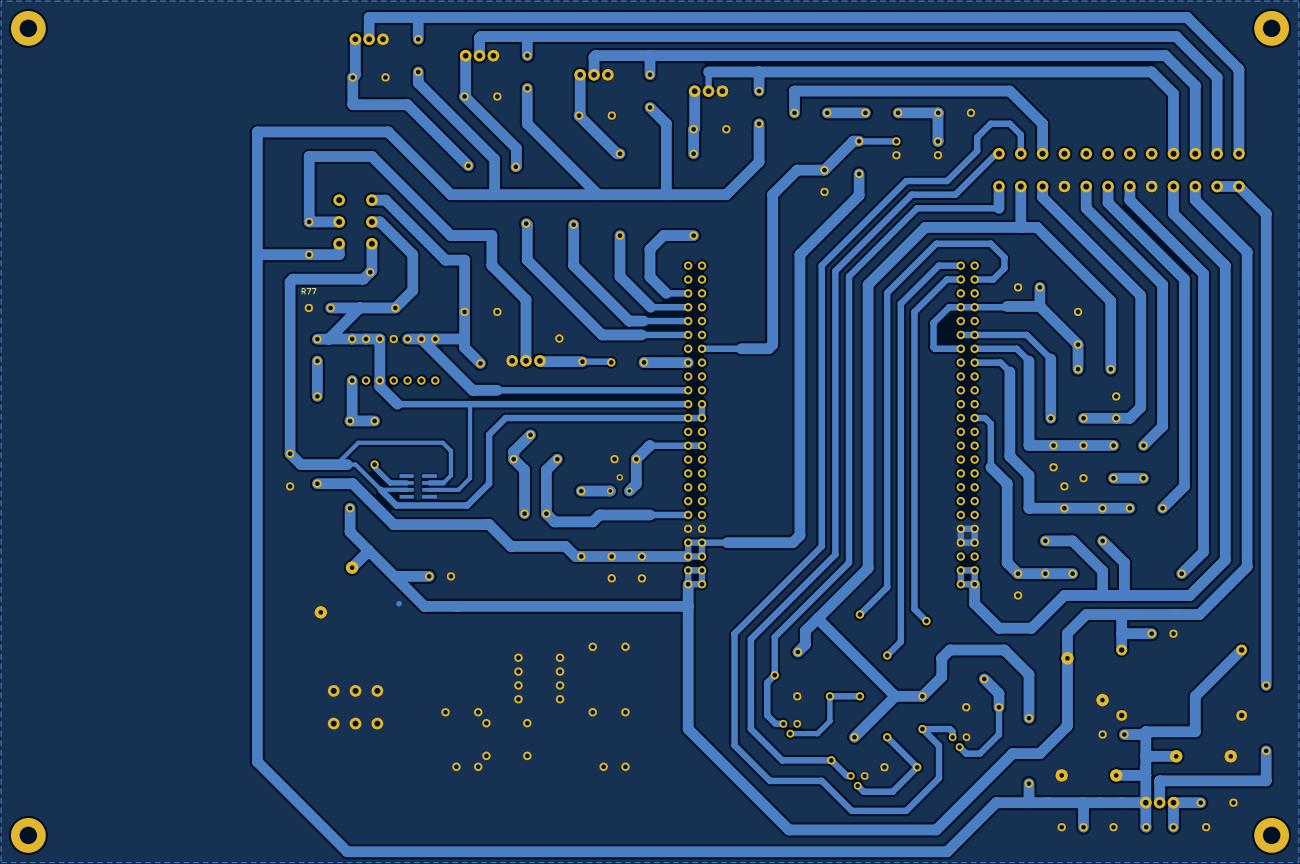
[picture p34: board injet-racing-prodv6.kicad_pcb from below]

Board: 2 copper layers, 102 parts (3 on the bottom side), 37 nets.

Parts:
C1: 220uF; C1
C2: 100nF; C2
C3: 100uF; C3
C4: 100nF; C4
C5: 220uF; C5
C6: 100nF; C6
C10: 100nF; C10
C11: 10uF; C11
C12: 10uF; C12
C20: 100nF; C20
C21: 100nF; C21
C22: 100nF; C22
C23: 100nF; C23
C24: 100nF; C24
C25: 1nF; C25
C30: 220nF; C30
C31: 220nF; C31
C32: 100nF; C32
C33: 10uF; C33
C40: 10nF; C40
C41: 1nF; C41
CN1: ATX-24; CN1
CN2: PCIe-6; CN2
CN4: PCIe-6 VR; CN2
D1: 15V Zener; D1
D2: TVS 33V; D2
D3: 1N4148; D3
D10: 1N4007; D10
D11: 1N4007; D11
D12: 1N4007; D12
D13: 1N4007; D13
D20: 1N4007; D20
D21: 1N4007; D21
D22: 1N4007; D22
D30: 1N4007; D30
D40: 1N4148; D40
D41: 1N4148; D41
F1, F1#2, F1#3, F2, F2#2, F2#3, F2#4: 5A; F1
H: MountingHole; MountingHole_3.2mm_M3
H#2, H#3, H#4: MountingHole; MountingHole_3.2mm_M3
Q1: IRF9540; QREV
Q10: IRLZ44N; Q10
Q11: IRLZ44N; Q11
Q12: IRLZ44N; Q12
Q13: IRLZ44N; Q13
Q20: 2N7000; Q20
Q21: 2N7000; Q21
Q22: 2N7000; Q22
Q30: IRLZ44N; Q30
R1: 100k; R1
R10, R11: 2.26k; R
R12, R40, R41, R42, R43, R55, R56, R57, R76, R77: 10k; R
R13: 18k; R13
R14, R91: 100k; R
R15: 10k; R15
R16, R17, R18, R19, R50, R51, R52: 1k; R
R20, R21: 10k 2W; R
R22, R92: 4k7; R
R30, R31, R32, R33, R80: 100R; R
R70: 61R9; R
R71: 6k8; R
R78: 1k; R78
R81: 10k; R81
R90: 47k; R
U1: STM32F4VE; BLACK_BOARD
U2: MP1584
U4: MCP6004; U6004
U5: OPA388IDR; U8628
U7: PC817
U8: REF3033; U8
U9: LM393

Connections:
+3V3: C10.A, C11.A, CN1.4, D40.K, F1#3.A, F1#3.B, F2#3.A, F2#3.B, R10.A, R11.A, R22.B, R76.A, R92.A, U1.L0I, U1.L0O, U1.L1I, U1.L1O, U1.R2I, U1.R2O, U1.R3I, U1.R3O, U8.1, U9.8
+5V: C5.A, C6.A, C32.A, C33.A, CN1.3, F1.A, F1.B, F2#4.A, F2#4.B, U1.R0I, U1.R0O, U1.R1I, U1.R1O, U2.3, U4.14, U5.7
+12V_BAT: CN1.1, CN1.2, F1#2.A
+12V_IN: F1#2.B, Q1.D
+12V_PROT: C1.A, C2.A, C3.A, C4.A, CN1.11, CN2.1, D2.A, D10.K, D11.K, D12.K, D13.K, D20.K, D21.K, D22.K, D30.K, F2.A, F2.B, Q1.S, R14.A, U2.1
CLT: C21.A, CN1.7, R11.B, R19.A, R19.B, U1.L16O
GHEAT: Q30.G, R80.A, R80.B, R81.A, U1.R16I
GINJ1: Q10.G, R30.A, R30.B, R40.A, U1.R18I
GINJ2: Q11.G, R31.A, R31.B, R41.A, U1.R19I
GINJ3: Q12.G, R32.A, R32.B, R42.A, U1.R20I
GINJ4: Q13.G, R33.A, R33.B, R43.A, U1.R21I
GND: C1.B, C2.B, C3.B, C4.B, C5.B, C6.B, C10.B, C11.B, C12.B, C20.B, C21.B, C22.B, C23.B, C24.B, C25.B, C30.B, C31.B, C32.B, C33.B, C40.B, C41.B, CN1.5, CN1.9, CN4.3, D1.K, D2.K, D3.A, D41.A, Q10.S, Q11.S, Q12.S, Q13.S, Q20.S, Q21.S, Q22.S, Q30.S, R1.B, R13.B, R15.B, R40.B, R41.B, R42.B, R43.B, R55.B, R56.B, R57.B, R77.B, R81.B, U1.L3I, U1.L3O, U1.L4I, U1.L4O, U1.R4I, U1.R4O, U2.2, U2.4, U4.4, U5.4, U7.2, U7.3, U8.2, U9.4
GRL1: Q20.G, R50.A, R50.B, R55.A, U1.L22I
GRL2: Q21.G, R51.A, R51.B, R56.A, U1.L23I
GRL3: Q22.G, R52.A, R52.B, R57.A, U1.L22O
H-: CN2.2, D30.A, Q30.D
IAT: C20.A, CN1.6, R10.B, R18.A, R18.B, U1.L12O
INJ1: CN1.13, D10.A, Q10.D
INJ2: CN1.14, D11.A, Q11.D
INJ3: CN1.15, D12.A, Q12.D
INJ4: CN1.16, D13.A, Q13.D
IP: C30.A, CN2.4, R70.A, U1.R12I, U1.R12O, U1.R13O, U5.2, U5.6
MAP: C22.A, CN1.8, R12.A, R12.B, R13.A, R16.A, R16.B, U1.L17O
QG: D1.A, Q1.G, R1.A
RI_PULSE: R71.B, R78.B, U1.R5I
RL1: CN1.23, D20.A, Q20.D
RL2: CN1.24, D21.A, Q21.D
RL3: CN1.12, D22.A, Q22.D
RPM_IN: C25.A, CN1.22, D3.K, R20.A, R20.B, R21.A, R21.B, R22.A, U1.R17O, U7.1, U7.4
RPM_VR: C41.A, R91.A, R92.B, U9.1
TPS: C23.A, CN1.10, R17.A, R17.B, U1.L18I, U1.L18O
UN: C31.A, CN2.6, F2#2.A, F2#2.B, R71.A, R78.A, U1.R14I, U4.5, U4.6, U4.7
VBAT: C24.A, R14.B, R15.A, U1.L17I, U1.L20I, U1.L20O
VM: CN2.5, R70.B, R76.B, R77.A, U1.R13I, U4.1, U4.2, U4.3, U4.12, U5.3
VR+: CN4.1, R90.A
VREF+: C12.A, U1.R10I, U1.R10O, U8.3
VR_LIM: C40.A, D40.A, D41.K, R90.B, R91.B, U9.2
