bulinrutss/injet-racing/kicad/injet-racing-prodv3.kicad_pcb

## KiCad design kicad/injet-racing-prodv3.kicad_pcb (2026-08-06)

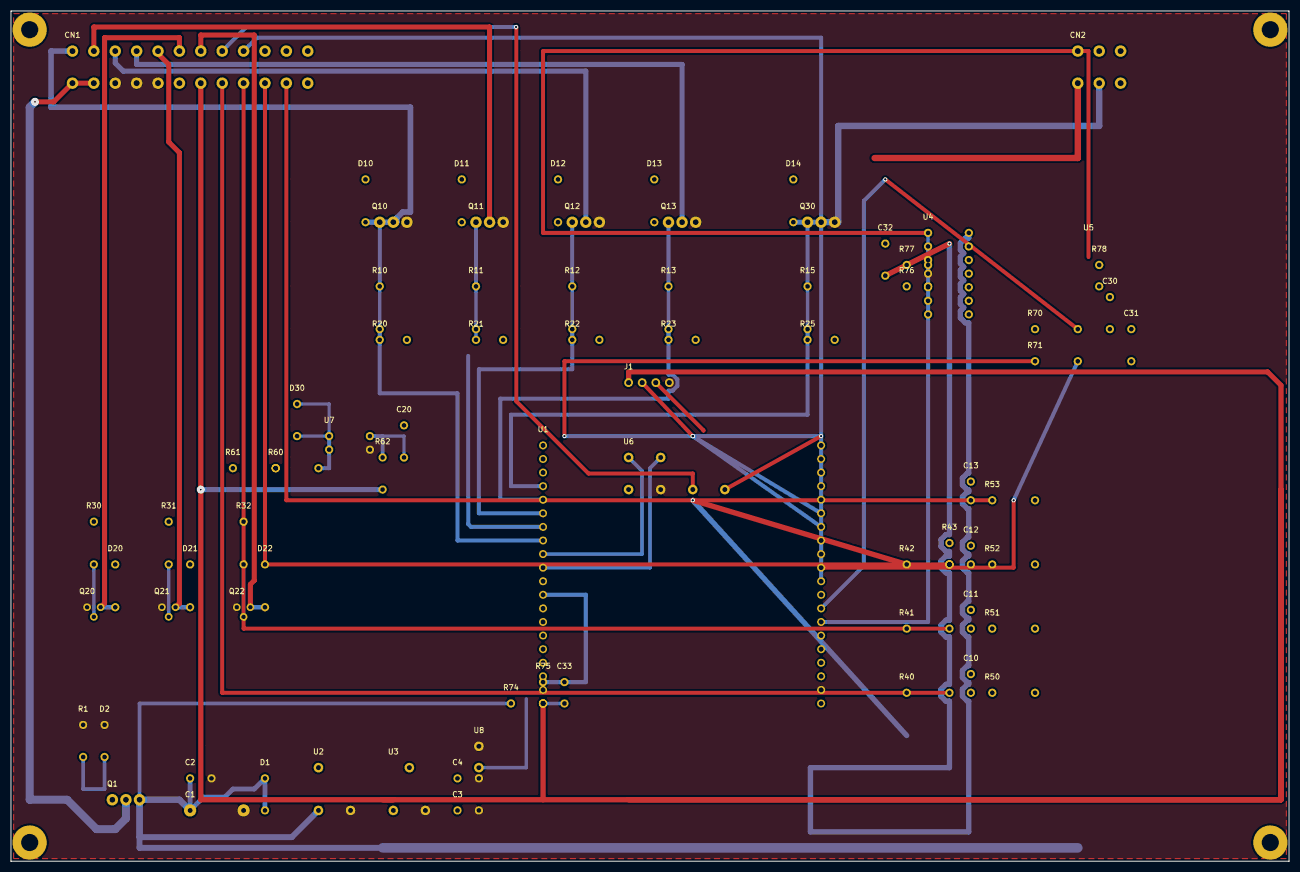
[picture p35: board injet-racing-prodv3.kicad_pcb from above]

Board: 2 copper layers, 239.0 x 159.0 mm, 80 parts (0 on the bottom side), 40 nets.

Parts:
C1: C1
C2: C2
C3: C3
C4: C4
C10: C10
C11: C11
C12: C12
C13: C13
C20: C20
C30: C30
C31: C31
C32: C32
C33: C33
CN1: ATX-24; CN1
CN2: PCIe-6 λ; CN2
D1: D1
D2: D2
D10: D10
D11: D11
D12: D12
D13: D13
D14: D14
D20: D20
D21: D21
D22: D22
D30: D30
H: MountingHole_3.2mm_M3
H#2, H#3, H#4: MountingHole_3.2mm_M3
J1: SWD 4p; SWD
Q1: IRF9540; QREV
Q10: IRLZ44N; QINJ1
Q11: IRLZ44N; QINJ2
Q12: IRLZ44N; QINJ3
Q13: IRLZ44N; QINJ4
Q20: 2N7000; QRL1
Q21: 2N7000; QRL2
Q22: 2N7000; QRL3
Q30: IRLZ44N; QHEAT
R1: R1
R10: R10
R11: R11
R12: R12
R13: R13
R15: R15
R20: R20
R21: R21
R22: R22
R23: R23
R25: R25
R30: R30
R31: R31
R32: R32
R40: R40
R41: R41
R42: R42
R43: R43
R50: R50
R51: R51
R52: R52
R53: R53
R60: R60
R61: R61
R62: R62
R70: R70
R71: R71
R74: R74
R75: R75
R76: R76
R77: R77
R78: R78
U1: STM32F407 Black Board; MCU
U2: MP1584; BUCK
U3: LDO 3V3; LDO
U4: MCP6004; U6004
U5: AD8628; U8628
U6: SN65HVD230; CAN
U7: PC817; U817
U8: REF3033; U8

Connections:
+3V3: CN1.7, J1.1, R42.A, R62.A, R74.B, R75.A, U1.L1
+5V: C32.A, CN1.6, U4.14
+12V_IN: CN1.1, CN1.2, Q1.D
+12V_PROT: C1.A, C2.A, CN2.1, D1.A, D1.K, Q1.S, U2.VIN
CANH: CN1.20, U6.H
CANL: CN1.21, U6.L
CAN_RX: U1.L11, U6.RX
CAN_TX: U1.L12, U6.TX
CLT: CN1.9, R41.B
DAC_VM: R76.B, U1.R7, U4.1, U4.2, U4.5
GHEAT: Q30.G, R15.A, R15.B, R25.A, U1.L17
GINJ1: Q10.G, R10.A, R10.B, R20.A, U1.L13
GINJ2: Q11.G, R11.A, R21.A
GINJ3: Q12.G, R12.A, R12.B, R22.A, U1.L15
GINJ4: Q13.G, R13.A, R13.B, R23.A, U1.L16
GND: C1.B, C2.B, C3.B, C4.B, CN1.3, CN1.4, CN1.5, D2.K, J1.4, Q10.S, Q11.S, Q12.S, Q13.S, Q20.S, Q21.S, Q22.S, Q30.S, R1.B, U1.L2, U1.R2, U2.GND, U3.GND, U4.4, U5.4, U6.GND, U7.3, U8.GND
GRL1: Q20.G, R30.A
GRL2: Q21.G, R31.A
GRL3: Q22.G, R32.A
H-: CN2.2, D14.A, Q30.D
IAT: CN1.8, R40.B
INJ1: CN1.13, D10.A, Q10.D
INJ2: CN1.14, Q11.D
INJ3: CN1.15, Q12.D
INJ4: CN1.16, Q13.D
IP: CN2.3, R70.B, U1.R8
MAP: CN1.10, D22.K, R42.B, R43.A
QG: D2.A, R1.A
RI_PULSE: R71.B, U1.R11
RL1: CN1.18, D20.A, Q20.D
RL2: CN1.17, D21.A, Q21.D
RL3: CN1.19, D22.A, Q22.D
RPM_IN: CN1.12, D30.A, D30.K, R60.B, U7.1, U7.2
RPM_OUT: C20.A, R62.B, U7.4
SWCLK: J1.3, U1.R15
SWDIO: J1.2, U1.R14
TPS: CN1.11, R53.A
UN: CN2.5, R71.A, U1.R10
VBAT: C33.A, R74.A, R75.B, U1.L9
VM: CN2.4, U5.3
