bulinrutss/injet-racing/kicad/injet-racing-prod.kicad_pcb

## KiCad design kicad/injet-racing-prod.kicad_pcb (2026-08-06)

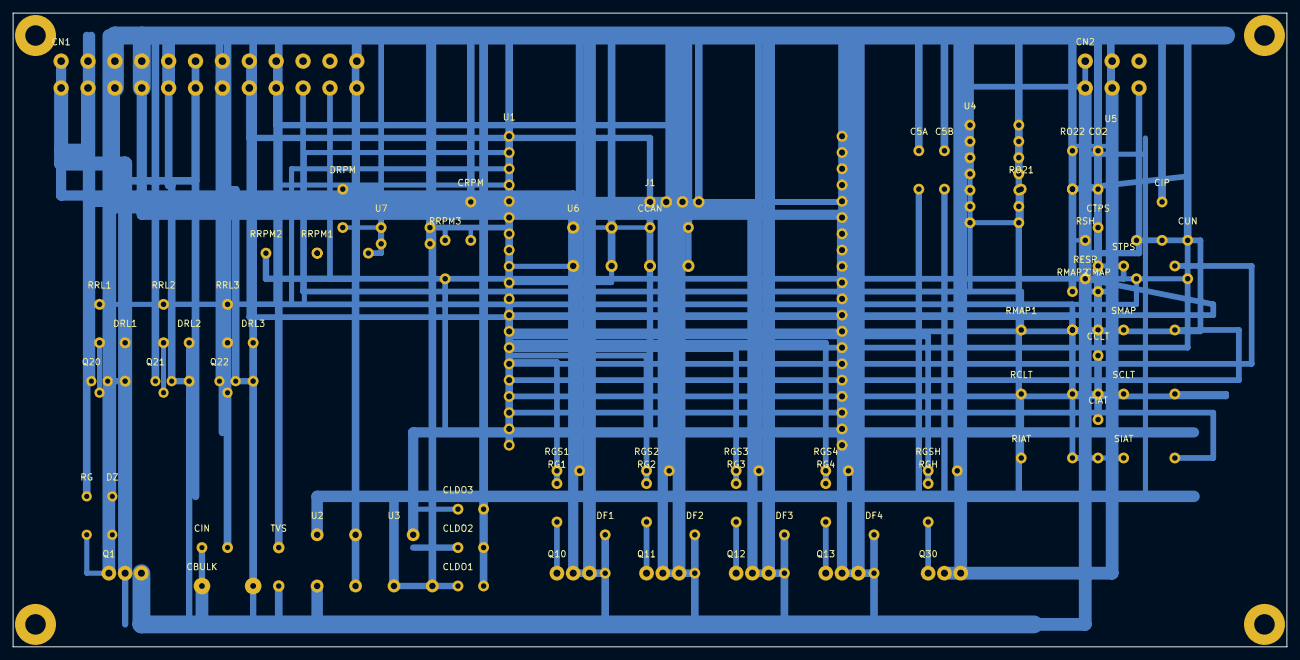
[picture p36: board injet-racing-prod.kicad_pcb from above]

Board: 2 copper layers, 199.0 x 99.0 mm, 78 parts (0 on the bottom side), 37 nets.

Parts:
C5A: C5A
C5B: C5B
CBULK: CBULK
CCAN: CCAN
CCLT: CCLT
CIAT: CIAT
CIN: CIN
CIP: CIP
CLDO1: CLDO1
CLDO2: CLDO2
CLDO3: CLDO3
CMAP: CMAP
CN1: ATX-24; CN1
CN2: PCIe-6 λ; CN2
CO2: CO2
CRPM: CRPM
CTPS: CTPS
CUN: CUN
DF1: DF1
DF2: DF2
DF3: DF3
DF4: DF4
DRL1: DRL1
DRL2: DRL2
DRL3: DRL3
DRPM: DRPM
DZ: DZ
H: MountingHole_3.2mm_M3
H#2, H#3, H#4: MountingHole_3.2mm_M3
J1: SWD 4p; SWD
Q1: IRF9540; QREV
Q10: IRLZ44N; QINJ1
Q11: IRLZ44N; QINJ2
Q12: IRLZ44N; QINJ3
Q13: IRLZ44N; QINJ4
Q20: 2N7000; QRL1
Q21: 2N7000; QRL2
Q22: 2N7000; QRL3
Q30: IRLZ44N; QHEAT
RCLT: RCLT
RESR: RESR
RG: RG
RG1: RG1
RG2: RG2
RG3: RG3
RG4: RG4
RGH: RGH
RGS1: RGS1
RGS2: RGS2
RGS3: RGS3
RGS4: RGS4
RGSH: RGSH
RIAT: RIAT
RMAP1: RMAP1
RMAP2: RMAP2
RO21: RO21
RO22: RO22
RRL1: RRL1
RRL2: RRL2
RRL3: RRL3
RRPM1: RRPM1
RRPM2: RRPM2
RRPM3: RRPM3
RSH: RSH
SCLT: SCLT
SIAT: SIAT
SMAP: SMAP
STPS: STPS
TVS: TVS
U1: STM32F407 Black Board; MCU
U2: MP1584; BUCK
U3: LDO 3V3; LDO
U4: MCP6004; U6004
U5: AD8628; U8628
U6: SN65HVD230; CAN
U7: PC817; U817

Connections:
+3V3: CCAN.A, CLDO2.A, CLDO3.A, CN1.7, J1.1, RCLT.A, RIAT.A, RRPM3.A, U1.L1, U1.L16, U3.OUT, U6.TX, U6.VCC
+5V: C5A.A, C5B.A, CLDO1.A, CN1.6, U1.R1, U2.VOUT, U3.IN, U4.14, U5.8
+12V_IN: CN1.1, CN1.2, Q1.D
+12V_PROT: CBULK.A, CIN.A, CN2.1, DF1.K, DF2.K, DF3.K, DF4.K, DRL1.K, DRL2.K, DRL3.K, Q1.S, TVS.A, U2.VIN
CANH: CN1.20, U6.H
CANL: CN1.21, U6.L
CAN_RX: U1.L11, U6.RX
CLT: CCLT.A, CN1.9, RCLT.B, SCLT.A, SCLT.B, U1.L4
GHEAT: Q30.G, RGH.A, RGH.B, RGSH.A, U1.L20
GINJ1: Q10.G, RG1.A, RG1.B, RGS1.A, U1.L6, U1.L13
GINJ2: Q11.G, RG2.A, RG2.B, RGS2.A, U1.L14
GINJ3: Q12.G, RG3.A, RG3.B, RGS3.A, U1.L7, U1.L15
GINJ4: Q13.G, RG4.A, RG4.B, RGS4.A
GND: C5A.B, C5B.B, CBULK.K, CCAN.B, CCLT.B, CIAT.B, CIN.K, CIP.B, CLDO1.B, CLDO2.B, CLDO3.B, CMAP.B, CN1.3, CN1.4, CN1.5, CN1.24, CO2.B, CRPM.B, CTPS.B, CUN.B, DZ.K, J1.4, Q1.G, Q10.S, Q11.S, Q12.S, Q13.S, Q20.S, Q21.S, Q22.S, Q30.S, RG.B, RGS1.B, RGS2.B, RGS3.B, RGS4.B, RGSH.B, RMAP2.B, RO22.B, TVS.K, U1.L2, U1.R2, U2.GND, U3.GND, U4.4, U4.11, U5.4, U6.GND, U7.3
GRL1: Q20.G, RRL1.A, RRL1.B, U1.L17
GRL2: Q21.G, RRL2.A, RRL2.B, U1.L18
GRL3: Q22.G, RRL3.A, RRL3.B, U1.L19
H-: CN2.2, Q30.D
IAT: CIAT.A, CN1.8, RIAT.B, SIAT.A, SIAT.B, U1.L3
INJ_FLY: DF1.A, DF2.A, DF3.A, DF4.A, Q10.D, Q11.D, Q12.D, Q13.D
IP: CIP.A, CN2.3, RSH.A, RSH.B, U1.L8
IP_DRV: U5.2, U5.6
MAP: CN1.10, RMAP1.A, RMAP1.B, RMAP2.A
MAP_ADC: SMAP.B, U1.L5
MAP_MID: CMAP.A, SMAP.A
O2: CO2.A, RO21.A, RO21.B, RO22.A, U4.7
QG: DZ.A, RG.A
RI_PULSE: RESR.B, U1.R8
RL_FLY: DRL1.A, DRL2.A, DRL3.A, Q20.D, Q21.D, Q22.D
RPM_IN: CN1.12, RRPM1.A, RRPM1.B, RRPM2.A, RRPM2.B, U7.1
RPM_LED: DRPM.A, DRPM.K, U7.2
RPM_OUT: CRPM.A, RRPM3.B, U1.L10, U7.4
SWCLK: J1.3, U1.R5
SWDIO: J1.2, U1.R4, U1.R16
TPS: CN1.11, CTPS.A, STPS.A, STPS.B
UN: CN2.5, CUN.A, RESR.A, U1.L9
VM: CN2.4, U1.R3, U4.1, U4.2, U4.3, U5.3
