bulinrutss/injet-racing/(commit log)

2026-08-08 Add initial rules and documentation for INJET RACING project, including primary communication guidelines, task order, and circuit fidelity standards. Updated pin assignments in firmware and added new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
    [injet-racing-prodv6.kicad_pcb]
2026-08-10 Refactor PCB layout and firmware pin assignments for improved connectivity and organization. Updated sensor pin mappings in `pins.h`, added new scripts for clearance and width analysis, and implement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
    [injet-racing-prodv6.kicad_pcb]
2026-08-15 Update PCB layout and firmware pin assignments for MOD6 and MOD7. Adjusted sensor mappings in `pins.h`, refined connectivity checks in `_check_mod6_now.py`, and added new scripts for MOD3 analysis. I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
    [injet-racing-prodv6.kicad_pcb]
2026-11-11 Add user manual and compatibility list for TBI components. Introduced new PDF files detailing product information and compatible TBI models for various motorcycle brands. Updated PCB layout and scrip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
    [injet-racing-prodv6.kicad_pcb, injet-racing-prodv6.kicad_sch, injet-racing-prodv7.kicad_pcb, lambda.kicad_sch]
2026-11-11 Track modulo documentation in the main repository.
    The notes lived in a nested git repo, so they never shipped with the ECU project.
2026-11-11 Enhance documentation for modulo integration and update related scripts. Consolidated notes from nested repository into main documentation for better accessibility. Improved clarity and organization 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
